tmartin07/Vehicle-wiring-diagrams/README.md

Vehicle-wiring-diagrams
=======================

OBSOLETE: USE FILES FROM BOX INSTEAD - Block diagrams and wiring diagrams between electrical modules on the vehicle.
