tmartin07/Vehicle-wiring-diagrams/M12 CAN.pdf

Pin | Name | Function | Wire color*
1 Brown | Shield | CAN Shield
2 White | +12V | +12V CAN Power
3 Blue | GND | CAN Ground
4 Black | CAN_H | CAN High
5 Green/Yellow | CAN_L | CAN Low

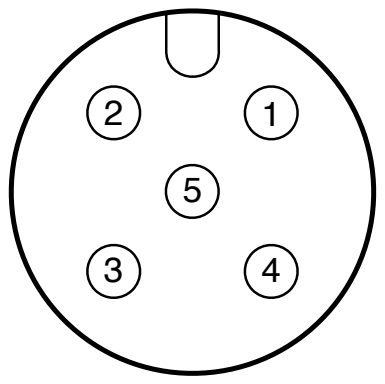
[picture p1: figure]

M12 5-position

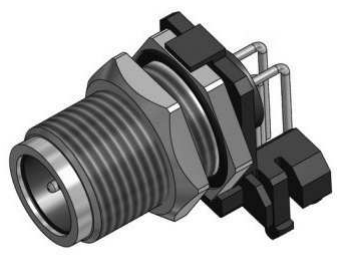
[picture p2: figure]

Connector name | M12 CAN
Drawing date | 05/19/15
Drawn by | Victor Brechbill

*Wire colors given are for Conec 43-1005x cable assemblies
