tmartin07/Vehicle-wiring-diagrams/MCN Breakout Pinouts.xls

Connector Number | Connector Type | Pin Number | Signal Type | MCN Signal | Associated Sensor
Front Magic CAN Node Breakout
X-401 | 8-pos M8 | 1 | 5V | +5V | Front WSS
 |  | 2 | 3V3 | +3V3 | Front Suspension
 |  | 3 | GPIO_5 | GP0 | Front WSS
 |  | 4 | Analog_3 | AIN-1 | Front Suspension
 |  | 5 | N/C
 |  | 6 | GND | GND | Front Suspension
 |  | 7 | GND | GND | Front WSS
 |  | 8 | N/C
X-402 | 8-pos M8 | 1 | 5V | +5V | Front Brake Pressure
 |  | 2 | 3V3 | +3V3 | Steering Angle
 |  | 3 | Analog_5 | AIN-2 | Front Brake Pressure
 |  | 4 | Analog_3 | AIN-3 | Steering Angle
 |  | 5 | Analog_3 | AIN-4 | Ambient Temperature
 |  | 6 | GND | GND | Ambient Temperature
 |  | 7 | GND | GND | Front Brake Pressure
 |  | 8 | GND | GND | Steering Angle
X-403 | 8-pos M8 | 1 | 5V | +5V | Radiator Air Pressure
 |  | 2 | N/C
 |  | 3 | Analog_5 | AIN-5 | Radiator Air Pressure 1
 |  | 4 | Analog_3 | AIN-6 | Radiator Coolant Temperature
 |  | 5 | N/C
 |  | 6 | Analog_5 | AIN-8 | Radiator Air Pressure 2
 |  | 7 | GND | GND | Radiator Coolant Temperature
 |  | 8 | GND | GND | Radiator Air Pressure
X-329 | 4-pos Micro-Fit | 1 | 5V | +5V | Ambient Pressure
 |  | 2 | Analog_5 | AIN-7 | Ambient Pressure
 |  | 3 | GND | GND | Ambient Pressure
 |  | 4 | N/C
Drive Control Magic CAN Node Breakout (attached to Front MCN Breakout board)
X-411 | 8-pos M8 | 1 | N/C
 |  | 2 | 3V3 | +3V3 | Power to Throttle
 |  | 3 | GPIO_12 | GP0 | Throttle Enable
 |  | 4 | Analog_3 | AIN-1 | Throttle
 |  | 5 | N/C
 |  | 6 | GND | GND | Ground to Throttle
 |  | 7 | N/C
 |  | 8 | N/C
Mid Magic CAN Node Breakout
X-404 | 8-pos M8 | 1 | 5V | +5V | Coolant Flow
 |  | 2 | GND | GND | Motor Coolant Temperature
 |  | 3 | GPIO_5 | GP0 | Coolant Flow
 |  | 4 | Analog_3 | AIN-11 | Motor Coolant Temperature
 |  | 5 | Analog_3 | AIN-12 | M/C Coolant Temperature
 |  | 6 | GND | GND | M/C Coolant Temperature
 |  | 7 | GND | GND | Coolant Flow
 |  | 8 | N/C
X-405 | 8-pos M8 | 1 | 5V | +5V | Motor Air Pressure
 |  | 2 | GND | GND | Motor Plate Temperature #1
 |  | 3 | Analog_5 | AIN-1 | Motor Air Pressure 1
 |  | 4 | Analog_3 | AIN-2 | Motor Plate Temperature #1
 |  | 5 | Analog_3 | AIN-3 | Motor Plate Temperature #2
 |  | 6 | Analog_5 | AIN-4 | Motor Air Pressure 2
 |  | 7 | GND | GND | Motor Air Pressure
 |  | 8 | GND | GND | Motor Plate Temperature #2
X-406 | 8-pos M8 | 1 | 5V | +5V | Strain Gauge
 |  | 2 | GND | GND | Strain Gauge
 |  | 3 | Analog_5 | AIN-5 | Strain Gauge
 |  | 4 | Analog_5 | AIN-6 | Strain Gauge
 |  | 5 | Analog_5 | AIN-7 | Strain Gauge
 |  | 6 | N/C
 |  | 7 | N/C
 |  | 8 | N/C
X-407 | 8-pos M8 | 1 | 5V | +5V | Strain Gauge
 |  | 2 | GND | GND | Strain Gauge
 |  | 3 | Analog_5 | AIN-8 | Strain Gauge
 |  | 4 | Analog_5 | AIN-9 | Strain Gauge
 |  | 5 | Analog_5 | AIN-10 | Strain Gauge
 |  | 6 | N/C
 |  | 7 | N/C
 |  | 8 | N/C
Rear Magic CAN Node Breakout
X-408 | 8-pos M8 | 1 | 3V3 | +3V3 | Rear Suspension
 |  | 2 | GND | GND | Rear Suspension
 |  | 3 | Analog_5 | AIN-1 | Rear Suspension
 |  | 4 | N/C
 |  | 5 | N/C
 |  | 6 | N/C
 |  | 7 | N/C
 |  | 8 | N/C
X-409 | 8-pos M8 | 1 | 5V | +5V | Rear WSS
 |  | 2 | GND | GND | Rear WSS
 |  | 3 | GPIO_5 | GP0 | Rear WSS
 |  | 4 | N/C
 |  | 5 | N/C
 |  | 6 | N/C
 |  | 7 | N/C
 |  | 8 | N/C
X-410 | 8-pos M8 | 1 | 5V | +5V | Rear Brake Pressure
 |  | 2 | GND | GND | Rear Brake Pressure
 |  | 3 | Analog_5 | AIN-2 | Rear Brake Pressure
 |  | 4 | N/C
 |  | 5 | N/C
 |  | 6 | N/C
 |  | 7 | N/C
 |  | 8 | N/C
X-336 | 4-pos Micro-Fit | 1 | 12V | +12V | Frame Fault
 |  | 2 | GND | GND | Frame Fault
 |  | 3 | Analog_12 | AIN-10 | 12V Standby
 |  | 4 | GPIO_12 | GP1 | Frame Fault
X-337 | 4-pos Micro-Fit | 1 | Analog_3 | AIN-3 | 12V Shunt
 |  | 2 | 3V3 | +3V3 | Power to 12V Shunt
 |  | 3 | Analog_3 | AIN-5 | DC-DC Temperature
 |  | 4 | GND | GND | DC-DC Temperature
X-413 | 8-pos M8 | 1 | 5V | +5V | Spare
 |  | 2 | 3V3 | +3V3
 |  | 3 | Analog_5 | AIN-6
 |  | 4 | Analog_3 | AIN-7
 |  | 5 | Analog_3 | AIN-8
 |  | 6 | GND | GND
 |  | 7 | GND | GND
 |  | 8 | GND | GND
Dyno MCN Breakout
X-5002 | 10-pos MicroClasp | 1 | 5V | +5V | Coolant Flow
 |  | 2 | GND | GND | Motor Coolant Temperature
 |  | 3 | GPIO_5 | GP0 | Coolant Flow
 |  | 4 | Analog_3 | AIN-11 | Motor Coolant Temperature
 |  | 5 | Analog_3 | AIN-12 | M/C Coolant Temperature
 |  | 6 | GND | GND | M/C Coolant Temperature
 |  | 7 | Analog_3 | AIN-10 | Radiator Coolant Temperature
 |  | 8 | GND | GND | Radiator Coolant Temperature
 |  | 9 | GND | GND | Coolant Flow
 |  | 10 | N/C
X-5003 | 10-pos MicroClasp | 1 | 5V | +5V | Coolant Pressure Sensor #1
 |  | 2 | Analog_5 | AIN-1 | Coolant Pressure Sensor #1
 |  | 3 | GND | GND | Coolant Pressure Sensor #1
 |  | 4 | 5V | +5V | Coolant Pressure Sensor #2
 |  | 5 | Analog_5 | AIN-2 | Coolant Pressure Sensor #2
 |  | 6 | N/C
 |  | 7 | N/C
 |  | 8 | N/C
 |  | 9 | N/C
 |  | 10 | GND | GND | Coolant Pressure Sensor #2
Rear CAN Backplane
X-340 | 2-pos Micro-Fit | 1 | 12V |  | CAN Power
 |  | 2 | GND
X-206 | 5-pos M12 | 1 | Shield |  | Tank Enclosure (CAN 2)
 |  | 2 | 12V
 |  | 3 | GND
 |  | 4 | CAN-H
 |  | 5 | CAN-L
X-207 | 5-pos M12 | 1 | Shield |  | Rear Tire Temperature
 |  | 2 | 12V
 |  | 3 | GND
 |  | 4 | CAN-H
 |  | 5 | CAN-L
X-339 | 6-pos Micro-Fit | 1 | 12V |  | Rear MCN
 |  | 2 | GND
 |  | 3 | Shield
 |  | 4 | CAN-H
 |  | 5 | CAN-L
 |  | 6 | Shield GND
Tank CAN Backplane
X-203 | 5-pos M12 | 1 | Shield |  | Motor Controller (CAN A)
 |  | 2 | 12V
 |  | 3 | GND
 |  | 4 | CAN-H
 |  | 5 | CAN-L
X-205 | 5-pos M12 | 1 | Shield |  | Front Tire Temperature (CAN 2)
 |  | 2 | 12V
 |  | 3 | GND
 |  | 4 | CAN-H
 |  | 5 | CAN-L
X-202 | 5-pos M12 | 1 | Shield |  | Rear Enclosure (CAN 2)
 |  | 2 | 12V
 |  | 3 | GND
 |  | 4 | CAN-H
 |  | 5 | CAN-L
X-201 | 5-pos M12 | 1 | Shield |  | Front Enclosure (CAN 2)
 |  | 2 | 12V
 |  | 3 | GND
 |  | 4 | CAN-H
 |  | 5 | CAN-L
X-204 | 5-pos M12 | 1 | Shield |  | BMS (CAN 2)
 |  | 2 | 12V
 |  | 3 | GND
 |  | 4 | CAN-H
 |  | 5 | CAN-L
X-321 | 6-pos Micro-Fit | 1 | 12V |  | Interface Panel (CAN A)
 |  | 2 | GND
 |  | 3 | Shield
 |  | 4 | CAN-H
 |  | 5 | CAN-L
 |  | 6 | Shield GND
X-322 | 6-pos Micro-Fit | 1 | 12V |  | Drive Control MCN (CAN A)
 |  | 2 | GND
 |  | 3 | Shield
 |  | 4 | CAN-H
 |  | 5 | CAN-L
 |  | 6 | Shield GND
X-320 | 6-pos Micro-Fit | 1 | 12V |  | CAN Mirror (CAN A)
 |  | 2 | GND
 |  | 3 | Shield
 |  | 4 | CAN-H
 |  | 5 | CAN-L
 |  | 6 | Shield GND
X-319 | 6-pos Micro-Fit | 1 | 12V |  | CAN Mirror (CAN 2)
 |  | 2 | GND
 |  | 3 | Shield
 |  | 4 | CAN-H
 |  | 5 | CAN-L
 |  | 6 | Shield GND
X-318 | 6-pos Micro-Fit | 1 | 12V |  | Front MCN (CAN 2)
 |  | 2 | GND
 |  | 3 | Shield
 |  | 4 | CAN-H
 |  | 5 | CAN-L
 |  | 6 | Shield GND
X-317 | 6-pos Micro-Fit | 1 | 12V |  | IMU MCN (CAN 2)
 |  | 2 | GND
 |  | 3 | Shield
 |  | 4 | CAN-H
 |  | 5 | CAN-L
 |  | 6 | Shield GND
X-316 | 6-pos Micro-Fit | 1 | 12V |  | Mid MCN (CAN 2)
 |  | 2 | GND
 |  | 3 | Shield
 |  | 4 | CAN-H
 |  | 5 | CAN-L
 |  | 6 | Shield GND
X-314 | 6-pos Micro-Fit | 1 | 12V |  | Kvaser (CAN 2)
 |  | 2 | GND
 |  | 3 | Shield
 |  | 4 | CAN-H
 |  | 5 | CAN-L
 |  | 6 | Shield GND
X-315 | 6-pos Micro-Fit | 1 | 12V |  | Interface Panel (CAN 2)
 |  | 2 | GND
 |  | 3 | Shield
 |  | 4 | CAN-H
 |  | 5 | CAN-L
 |  | 6 | Shield GND
X-313 | 2-pos Micro-Fit | 1 | 12V |  | Starlane
 |  | 2 | GND
