tmartin07/Vehicle-wiring-diagrams/PL-8 Balance Harness.pdf

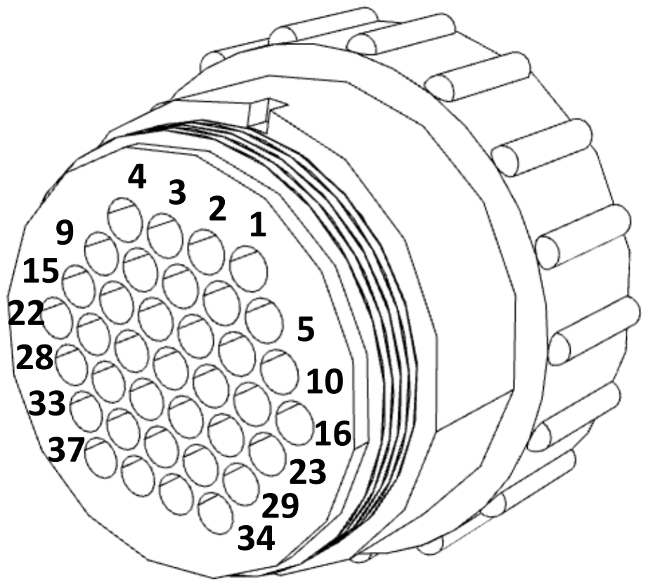
[picture p3: figure]

PL-8 Balance Harness
Victor Brechbill

05/19/15
Last modified: 2015-05-20

Page 1/1

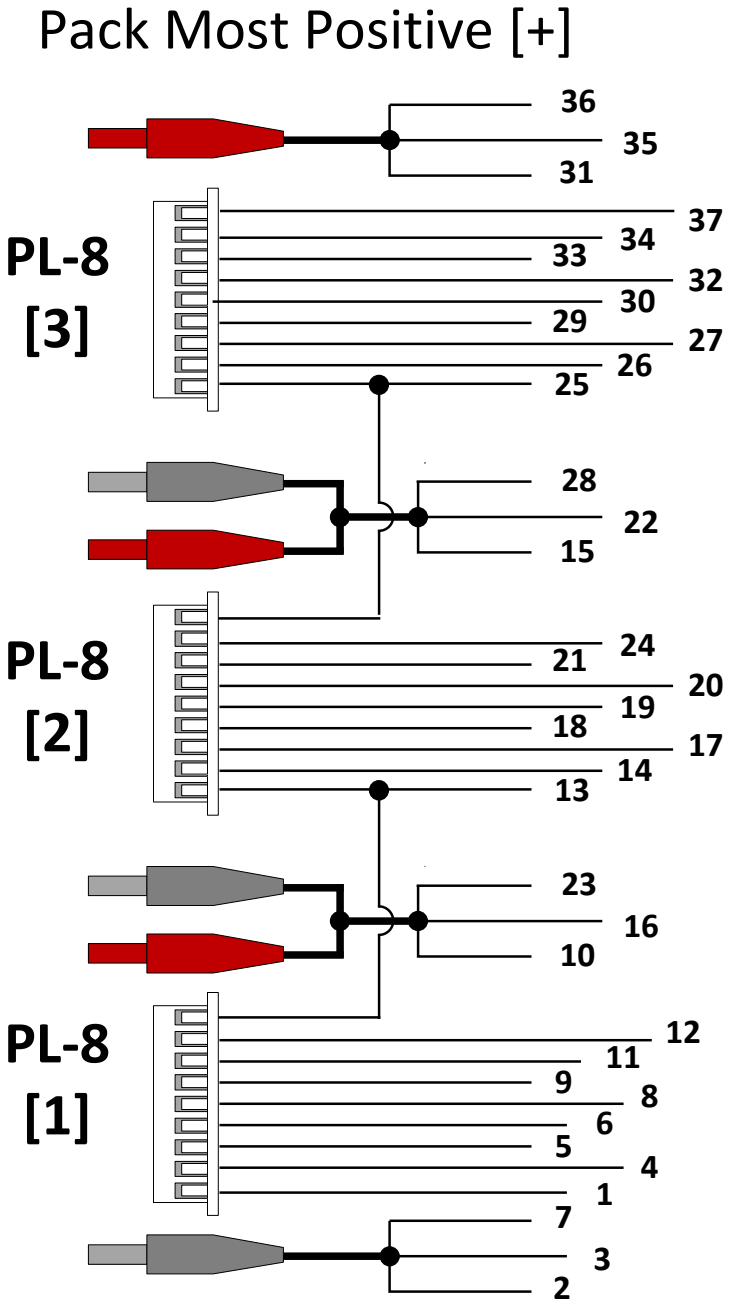
[picture p4: figure]
Pack Most Positive [+]

Pack Most Negative [-]

Back Side of Male Plug
(PN: 206305-1)
