tmartin07/Vehicle-wiring-diagrams/Complete System/System Block Diagram.pdf

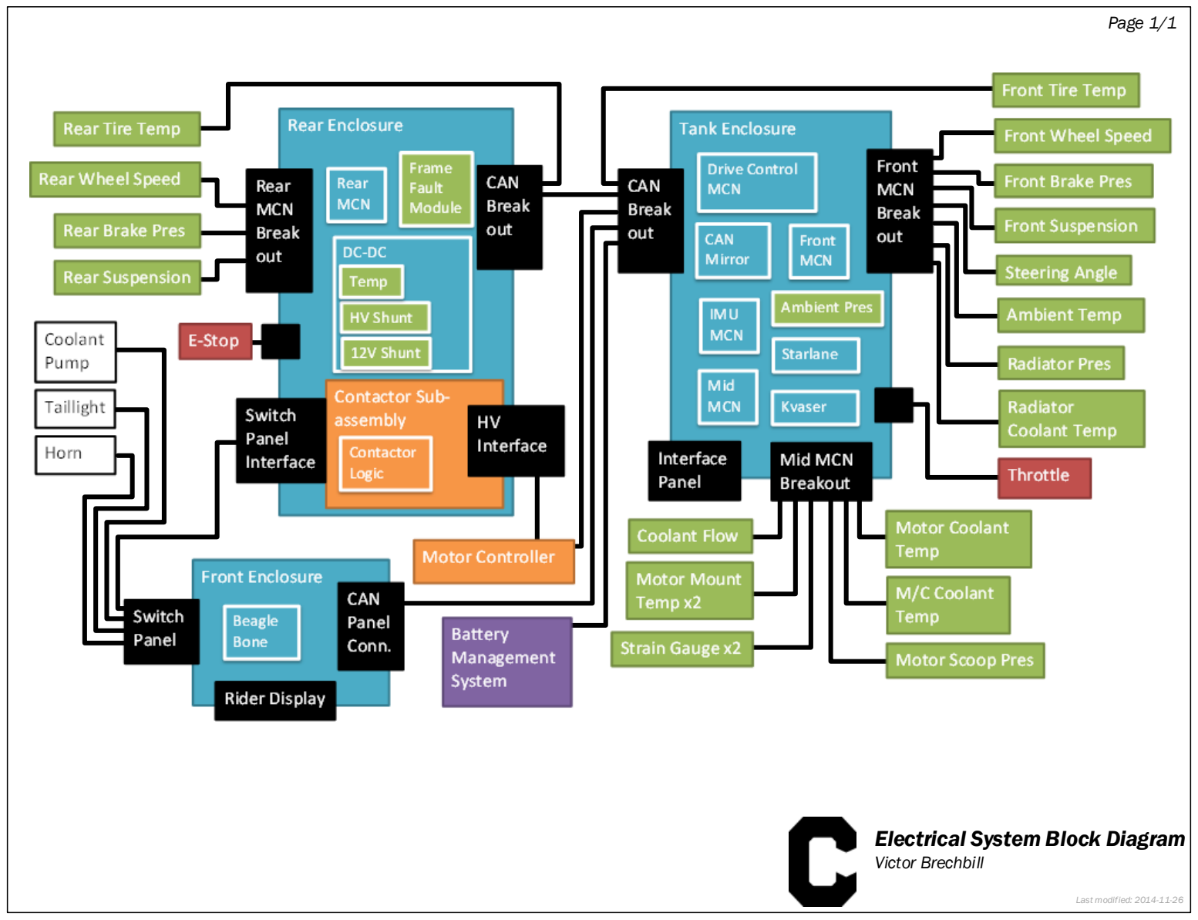
[picture p5: page 1]

Electrical System Block Diagram
Victor Brechbill

Last modified: 2014-11-26
