tmartin07/Vehicle-wiring-diagrams/Motor interface/RW-3 motor interface.pdf

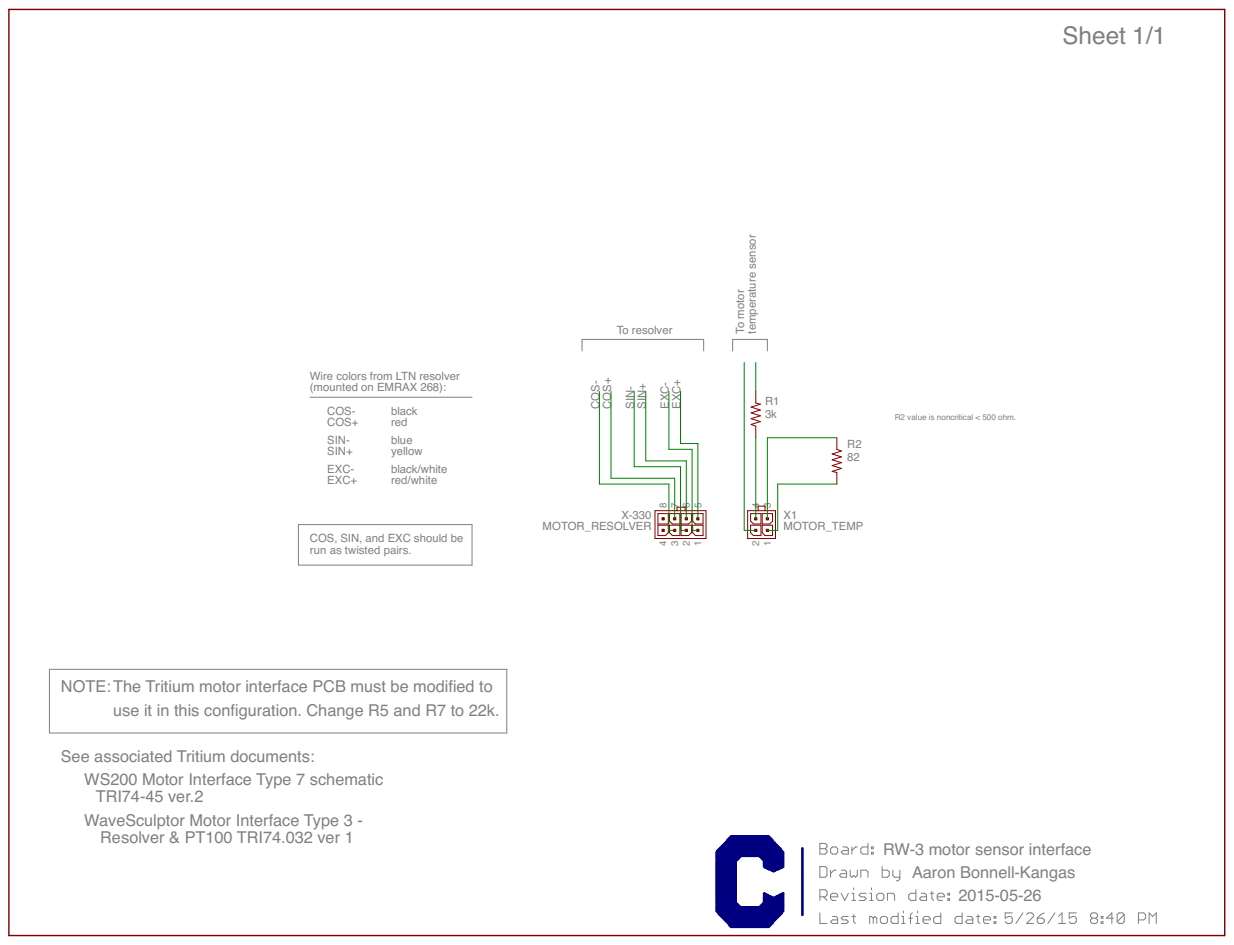
[picture p6: page 1]

Wire colors from LTN resolver COS- COS+ SIN- SIN+ EXC- EXC+
(mounted on EMRAX 268):

black/white blue black
red

R2 value is noncritical < 500 ohm.

COS, SIN, and EXC should be
run as twisted pairs.

use it in this configuration. Change R5 and R7 to 22k. The Tritium motor interface PCB must be modified to

See associated Tritium documents:
WS200 Motor Interface Type 7 schematic
TRI74-45 ver.2
WaveSculptor Motor Interface Type 3 - Resolver & PT100 TRI74.032 ver 1

RW-3 motor sensor interface
Aaron Bonnell-Kangas
