tmartin07/Vehicle-wiring-diagrams/Complete System/RW-3 Electrical System Diagram.pdf

## Front Enclosure

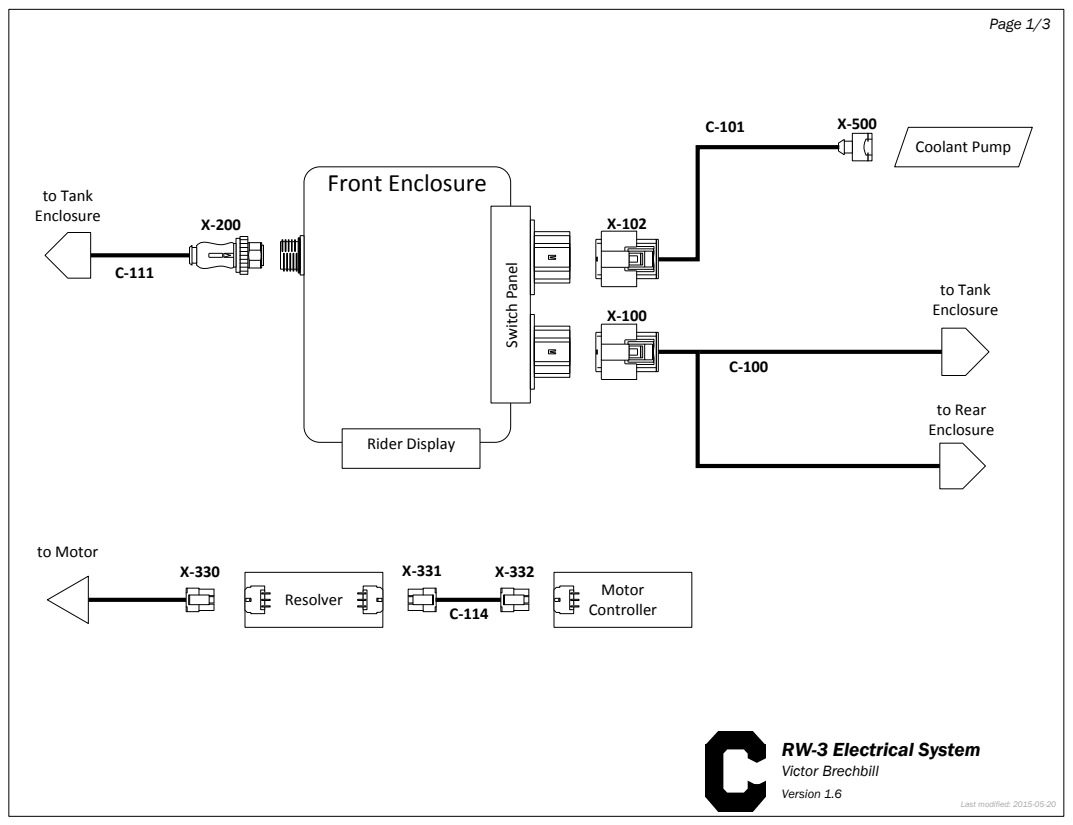
[picture p7: page 1]
Version 1.6; Last modified: 2015-05-20; Page 1/3; Switch Panel; Rider Display; Coolant Pump; to Rear Enclosure; to Tank Enclosure; Resolver; to Motor; Motor Controller

RW-3 Electrical System
Victor Brechbill

## Tank Enclosure

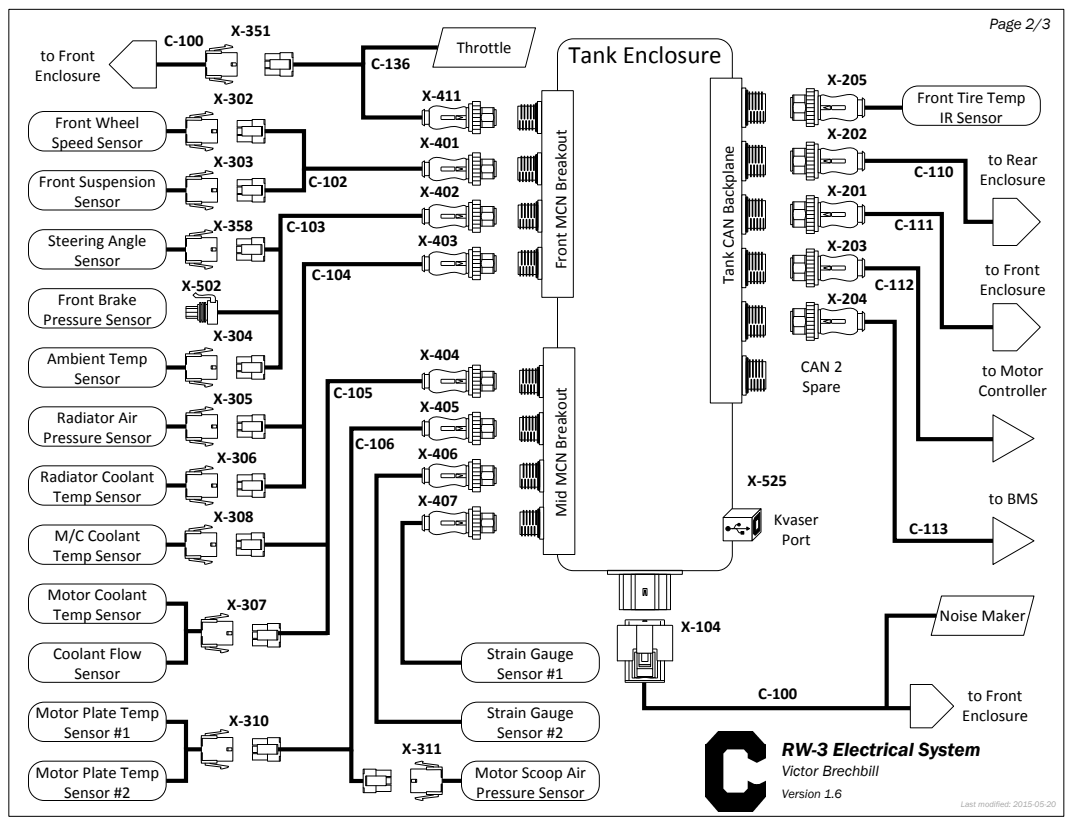
[picture p8: page 2]
Page 2/3; Front Wheel Speed Sensor; Front Suspension Sensor; Steering Angle Sensor; Front Brake Pressure Sensor; Ambient Temp Sensor; Radiator Air Pressure Sensor; Radiator Coolant Temp Sensor; M/C Coolant Temp Sensor; Motor Coolant Temp Sensor; Coolant Flow Sensor; Strain Gauge Sensor #1; Strain Gauge Sensor #2; to Motor Controller; to BMS; Throttle; Noise Maker; to Front Enclosure; Kvaser Port; CAN 2 Spare

Front Tire Temp
IR Sensor

Mid MCN Breakout Front MCN Breakout

Tank CAN Backplane to Front Enclosure to Rear Enclosure

Motor Plate Temp
Sensor #1

RW-3 Electrical System

Sensor #2

Motor Scoop Air
Pressure Sensor

## Rear Enclosure

E

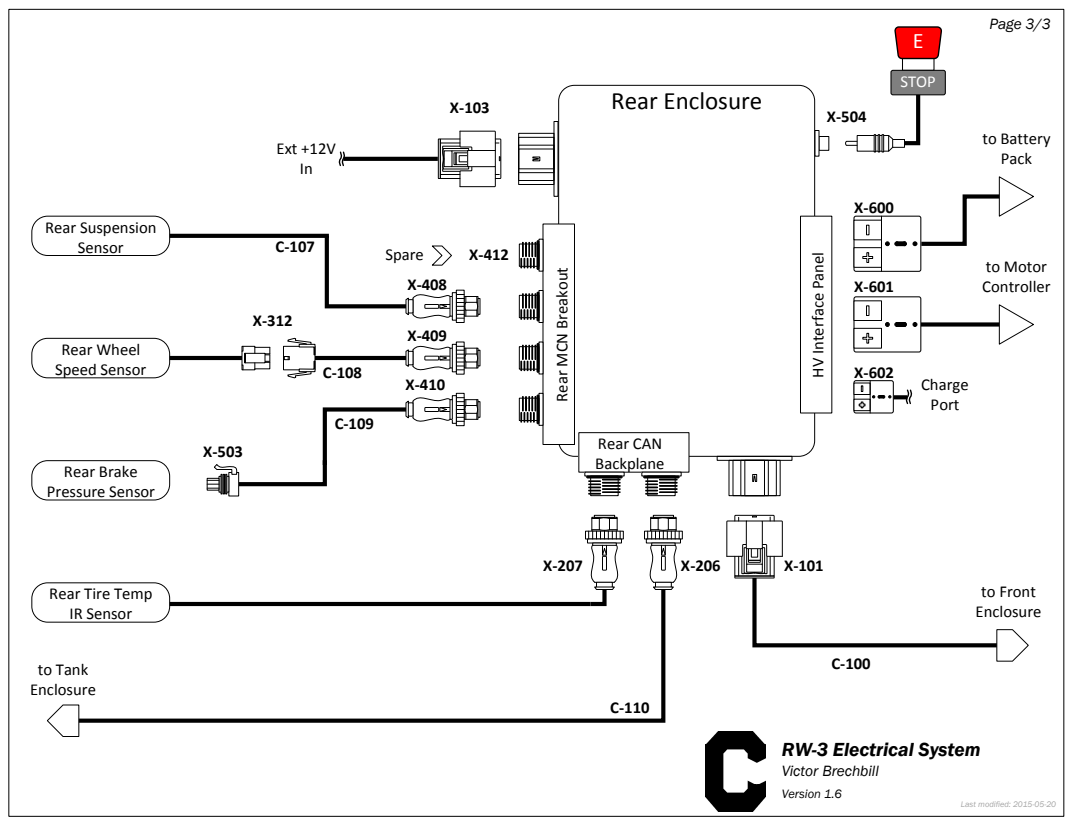
[picture p9: page 3]
Page 3/3; STOP; Rear Suspension Sensor; Rear Wheel Speed Sensor; Rear Brake Pressure Sensor; Spare; Rear CAN Backplane; Charge Port; to Front Enclosure; to Tank Enclosure; to Battery Pack; to Motor Controller; Ext +12V In

HV Interface Panel

Rear MCN Breakout

Rear Tire Temp
IR Sensor

RW-3 Electrical System
