tmartin07/Vehicle-wiring-diagrams/Complete System/X-310.pdf

## Micro-Fit - 4-circuit

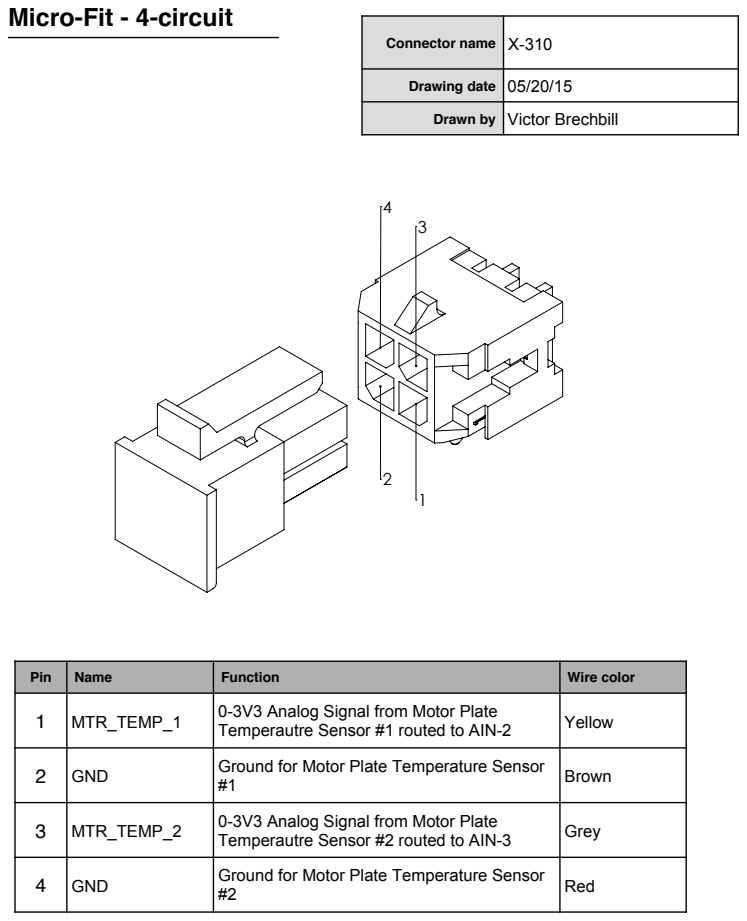
[picture p10: page 1]

Connector name | X-310

Drawing date | 05/20/15

Drawn by | Victor Brechbill

Pin | Name | Function | Wire color

1 | MTR_TEMP_1 | 0-3V3 Analog Signal from Motor Plate Temperautre Sensor #1 routed to AIN-2 | Yellow

2 | GND | Ground for Motor Plate Temperature Sensor #1 | Brown

3 | MTR_TEMP_2 | 0-3V3 Analog Signal from Motor Plate Temperautre Sensor #2 routed to AIN-3 | Grey

4 | GND | Ground for Motor Plate Temperature Sensor #2 | Red
