tmartin07/Vehicle-wiring-diagrams/Complete System/X-311.pdf

## Micro-Fit - 4-circuit

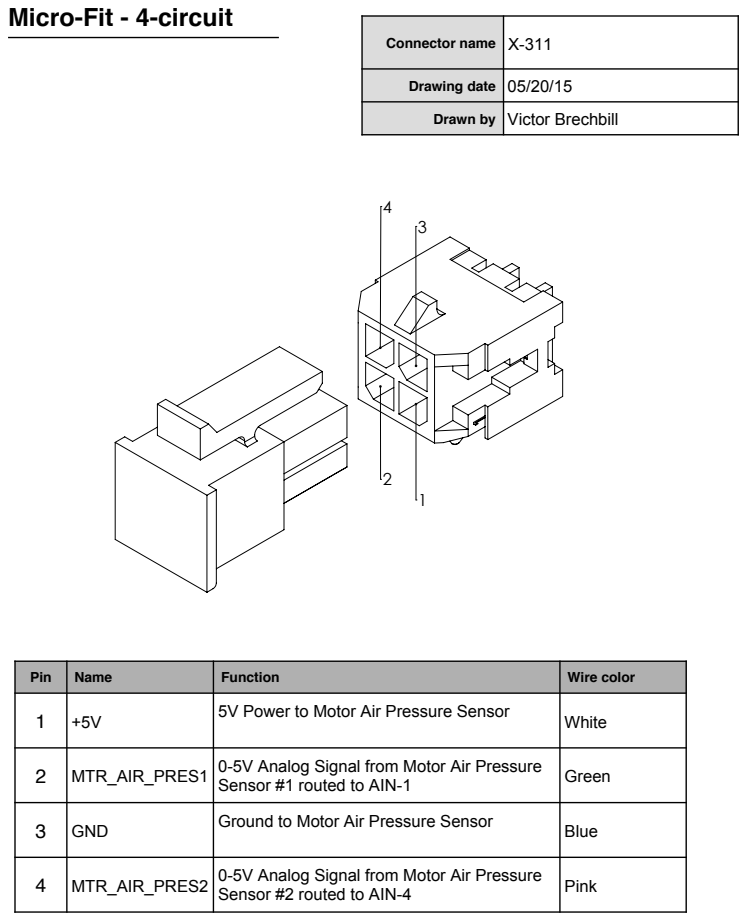
[picture p11: page 1]

Connector name | X-311

Drawing date | 05/20/15

Drawn by | Victor Brechbill

Pin | Name | Function | Wire color

1 | +5V | 5V Power to Motor Air Pressure Sensor | White

2 | MTR_AIR_PRES1 | 0-5V Analog Signal from Motor Air Pressure Sensor #1 routed to AIN-1 | Green

3 | GND | Ground to Motor Air Pressure Sensor | Blue

4 | MTR_AIR_PRES2 | 0-5V Analog Signal from Motor Air Pressure Sensor #2 routed to AIN-4 | Pink
