tmartin07/Vehicle-wiring-diagrams/Complete System/X-358.pdf

## Micro-Fit - 4-circuit

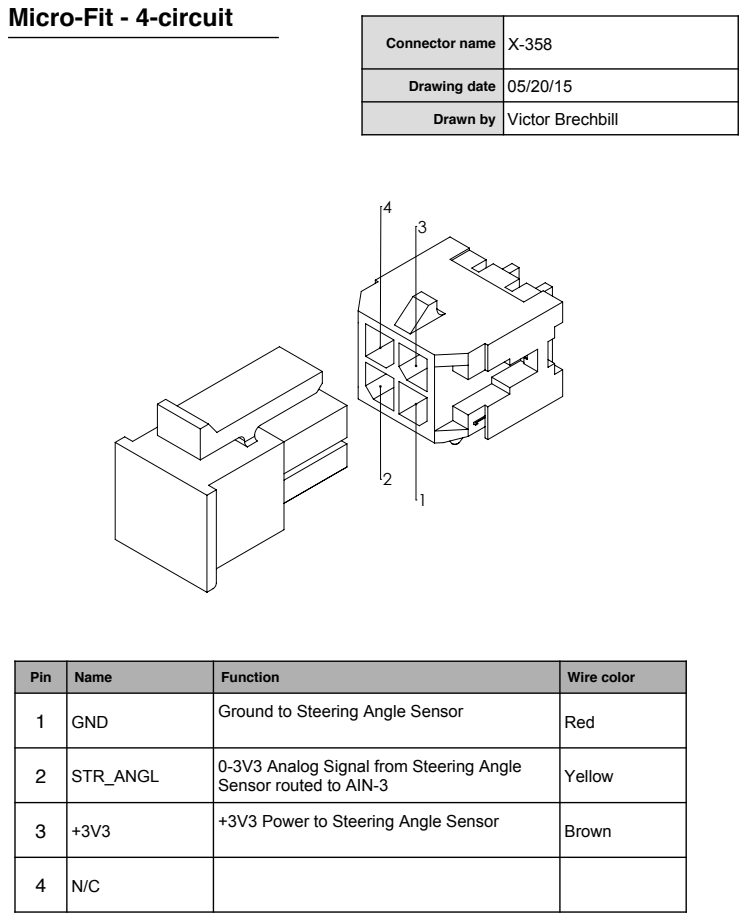
[picture p12: page 1]

Connector name | X-358

Drawing date | 05/20/15

Drawn by | Victor Brechbill

Pin | Name | Function | Wire color

1 | GND | Ground to Steering Angle Sensor | Red

2 | STR_ANGL | 0-3V3 Analog Signal from Steering Angle Sensor routed to AIN-3 | Yellow

3 | +3V3 | +3V3 Power to Steering Angle Sensor | Brown
