tmartin07/Vehicle-wiring-diagrams/Rear Enclosure/X-336.pdf

## Micro-Fit - 4-circuit

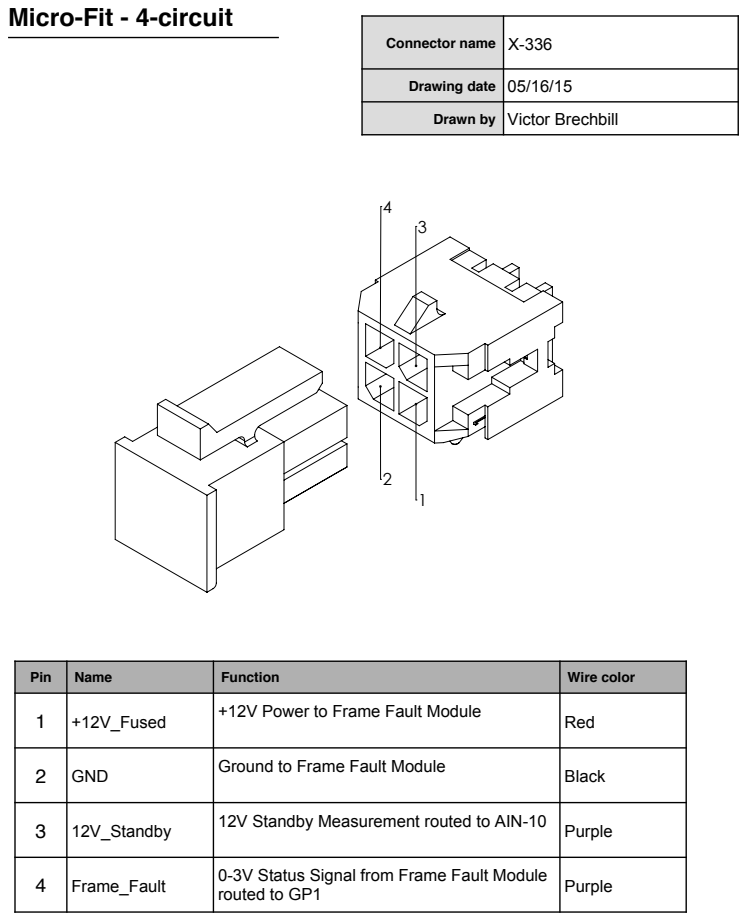
[picture p13: page 1]

Connector name | X-336

Drawing date | 05/16/15

Drawn by | Victor Brechbill

Pin | Name | Function | Wire color

1 | +12V_Fused | +12V Power to Frame Fault Module | Red

2 | GND | Ground to Frame Fault Module | Black

3 | 12V_Standby | 12V Standby Measurement routed to AIN-10 | Purple

4 | Frame_Fault | 0-3V Status Signal from Frame Fault Module routed to GP1 | Purple
