tmartin07/Vehicle-wiring-diagrams/Rear Enclosure/X-337.pdf

## Micro-Fit - 4-circuit

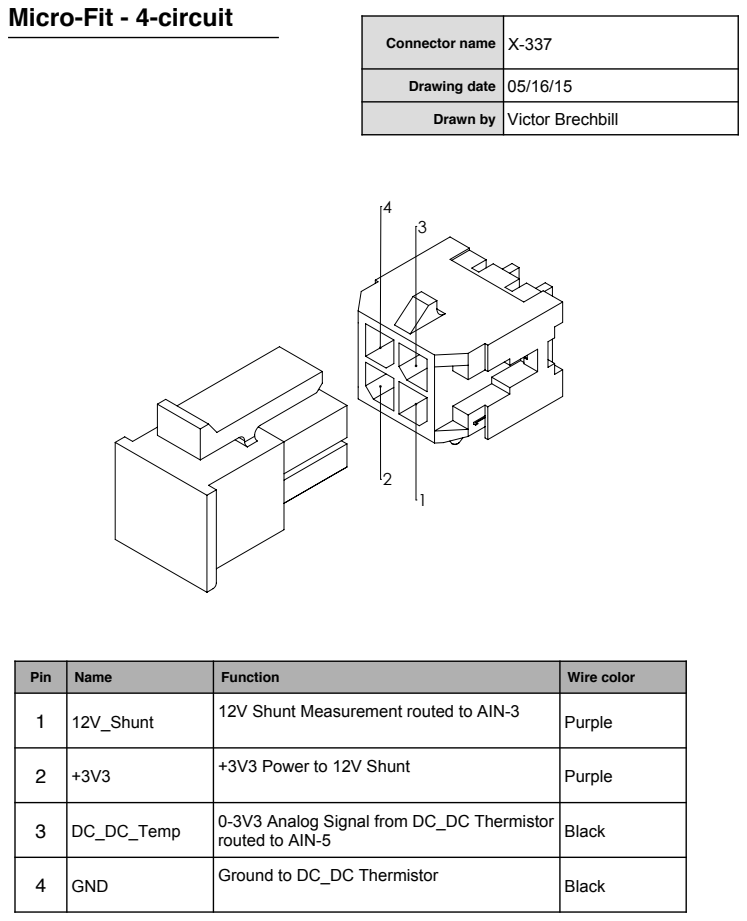
[picture p14: page 1]

Connector name | X-337

Drawing date | 05/16/15

Drawn by | Victor Brechbill

Pin | Name | Function | Wire color

1 | 12V_Shunt | 12V Shunt Measurement routed to AIN-3 | Purple

2 | +3V3 | +3V3 Power to 12V Shunt | Purple

3 | DC_DC_Temp | 0-3V3 Analog Signal from DC_DC Thermistor routed to AIN-5 | Black

4 | GND | Ground to DC_DC Thermistor | Black
