tmartin07/Vehicle-wiring-diagrams/Rear Enclosure/X-408.pdf

## M8 8-position

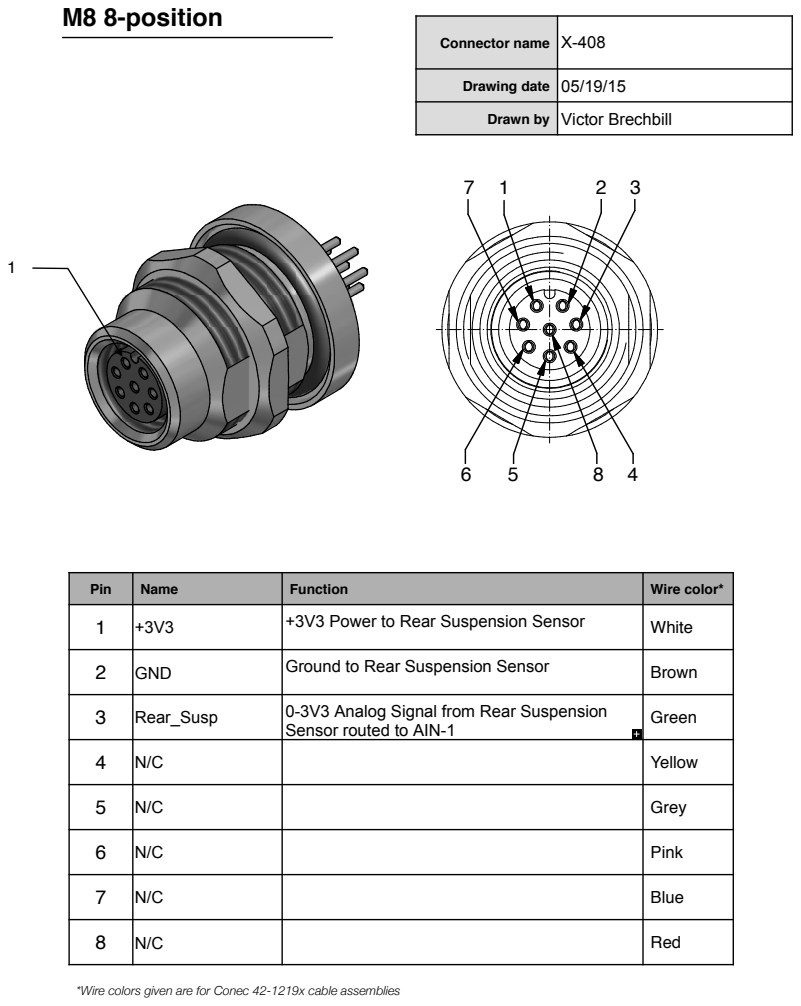
[picture p15: page 1]

Connector name | X-408

Drawing date | 05/19/15

Drawn by | Victor Brechbill

Pin | Name | Function | Wire color*

1 White | +3V3 | +3V3 Power to Rear Suspension Sensor

2 Brown | GND | Ground to Rear Suspension Sensor

3 Green | Rear_Susp | 0-3V3 Analog Signal from Rear Suspension

Sensor routed to AIN-1

4 Yellow | N/C

5 Grey | N/C

6 Pink | N/C

7 Blue | N/C

8 Red | N/C

*Wire colors given are for Conec 42-1219x cable assemblies
