tmartin07/Vehicle-wiring-diagrams/Rear Enclosure/X-409.pdf

## M8 8-position

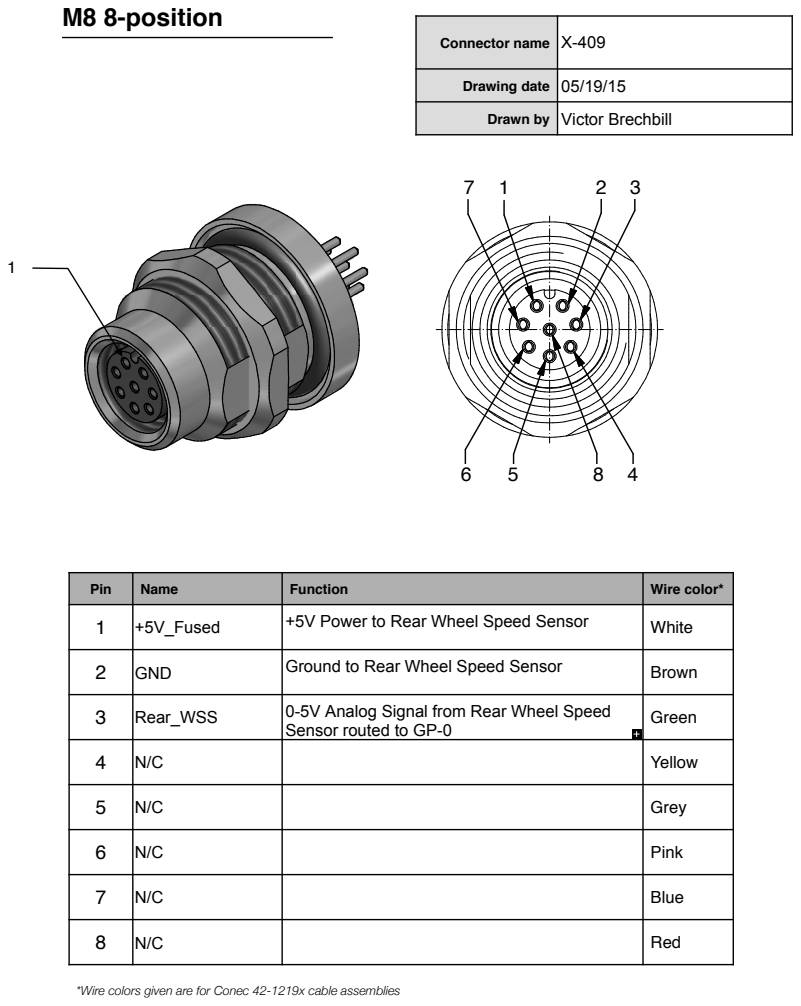
[picture p16: page 1]

Connector name | X-409

Drawing date | 05/19/15

Drawn by | Victor Brechbill

Pin | Name | Function | Wire color*

1 White | +5V_Fused | +5V Power to Rear Wheel Speed Sensor

2 Brown | GND | Ground to Rear Wheel Speed Sensor

3 Green | Rear_WSS | 0-5V Analog Signal from Rear Wheel Speed

Sensor routed to GP-0

4 Yellow | N/C

5 Grey | N/C

6 Pink | N/C

7 Blue | N/C

8 Red | N/C

*Wire colors given are for Conec 42-1219x cable assemblies
