tmartin07/Vehicle-wiring-diagrams/Rear Enclosure/X-410.pdf

## M8 8-position

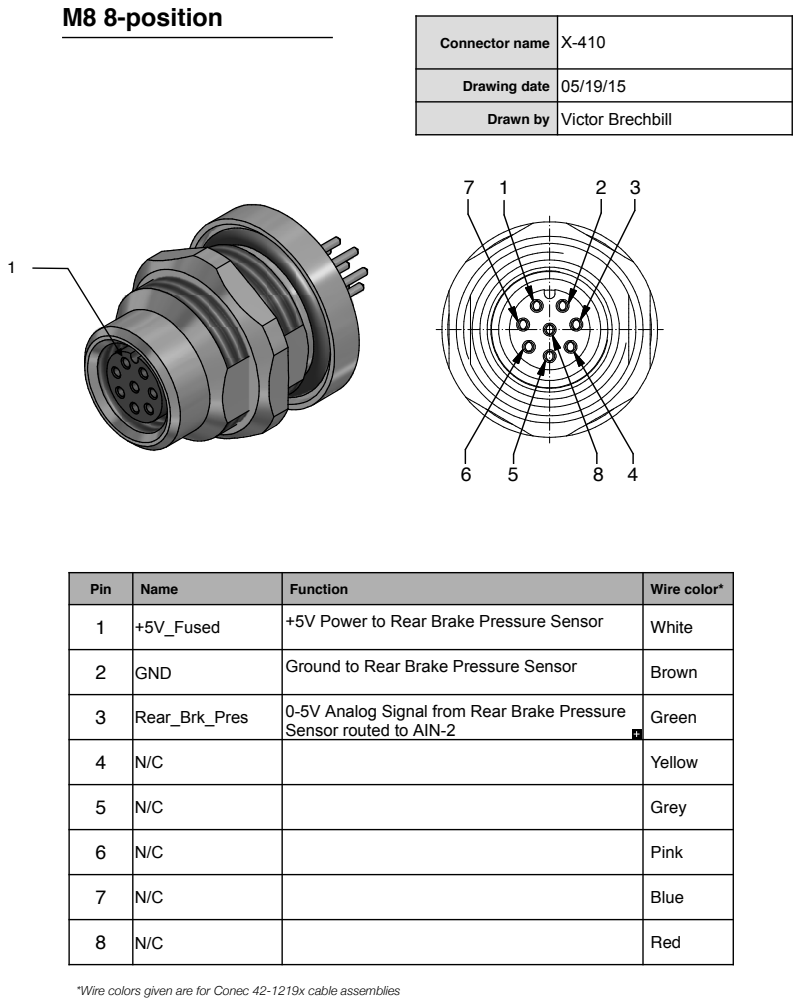
[picture p17: page 1]

Connector name | X-410

Drawing date | 05/19/15

Drawn by | Victor Brechbill

Pin | Name | Function | Wire color*

1 White | +5V_Fused | +5V Power to Rear Brake Pressure Sensor

2 Brown | GND | Ground to Rear Brake Pressure Sensor

3 Green | Rear_Brk_Pres | 0-5V Analog Signal from Rear Brake Pressure

Sensor routed to AIN-2

4 Yellow | N/C

5 Grey | N/C

6 Pink | N/C

7 Blue | N/C

8 Red | N/C

*Wire colors given are for Conec 42-1219x cable assemblies
