tmartin07/Vehicle-wiring-diagrams/Rear Enclosure/X-413.pdf

## M8 8-position

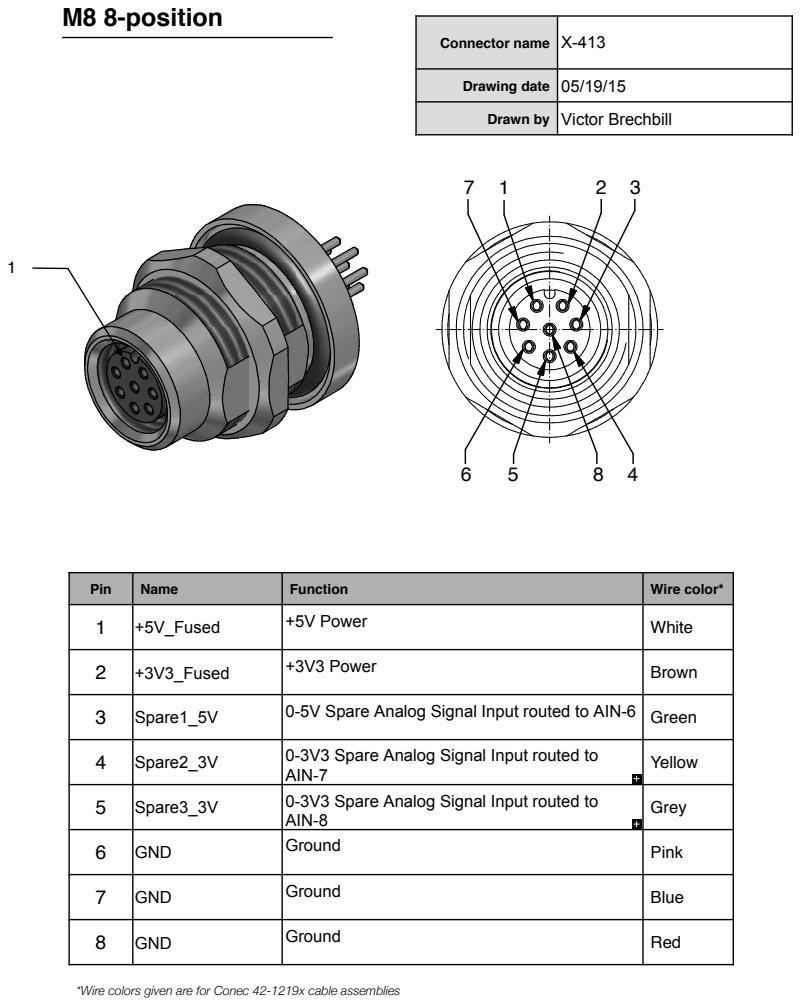
[picture p18: page 1]
AIN-7; AIN-8

Connector name | X-413

Drawing date | 05/19/15

Drawn by | Victor Brechbill

Pin | Name | Function | Wire color*

1 White | +5V_Fused | +5V Power

2 Brown | +3V3_Fused | +3V3 Power

3 Green | Spare1_5V | 0-5V Spare Analog Signal Input routed to AIN-6

4 Yellow | Spare2_3V | 0-3V3 Spare Analog Signal Input routed to

5 Grey | Spare3_3V | 0-3V3 Spare Analog Signal Input routed to

6 Pink | GND | Ground

7 Blue | GND | Ground

8 Red | GND | Ground

*Wire colors given are for Conec 42-1219x cable assemblies
