tmartin07/Vehicle-wiring-diagrams/Complete System/X-105.pdf

## MX-150L - 4-circuit

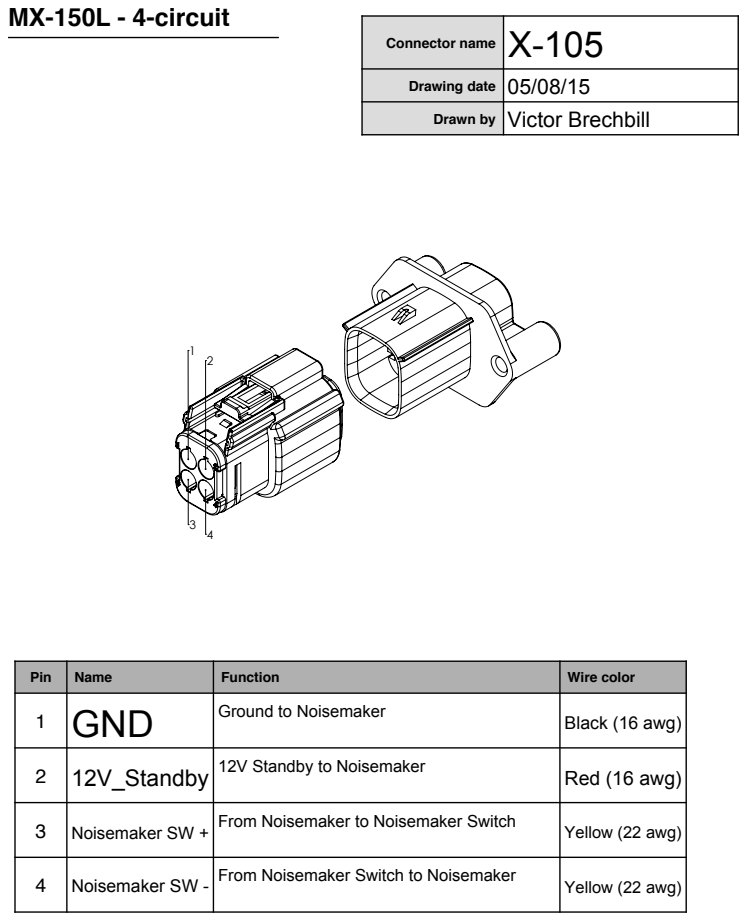
[picture p19: page 1]
0DWHGDVVHPEO\0;/SRV

Connector name | X-105

Drawing date | 05/08/15

Drawn by | Victor Brechbill

7KH2KLR6WDWH8QLYHUVLW\
'HSWRI0HFKDQLFDO $HURVSDFH(QJ

Pin | Name | Function | Wire color

1 | GND | Ground to Noisemaker | Black (16 awg)

2 | 12V_Standby | 12V Standby to Noisemaker | Red (16 awg)

3 | Noisemaker SW + | From Noisemaker to Noisemaker Switch | Yellow (22 awg)

4 | Noisemaker SW - | From Noisemaker Switch to Noisemaker | Yellow (22 awg)
