tmartin07/Vehicle-wiring-diagrams/Complete System/X-302.pdf

## Micro-Fit - 4-circuit

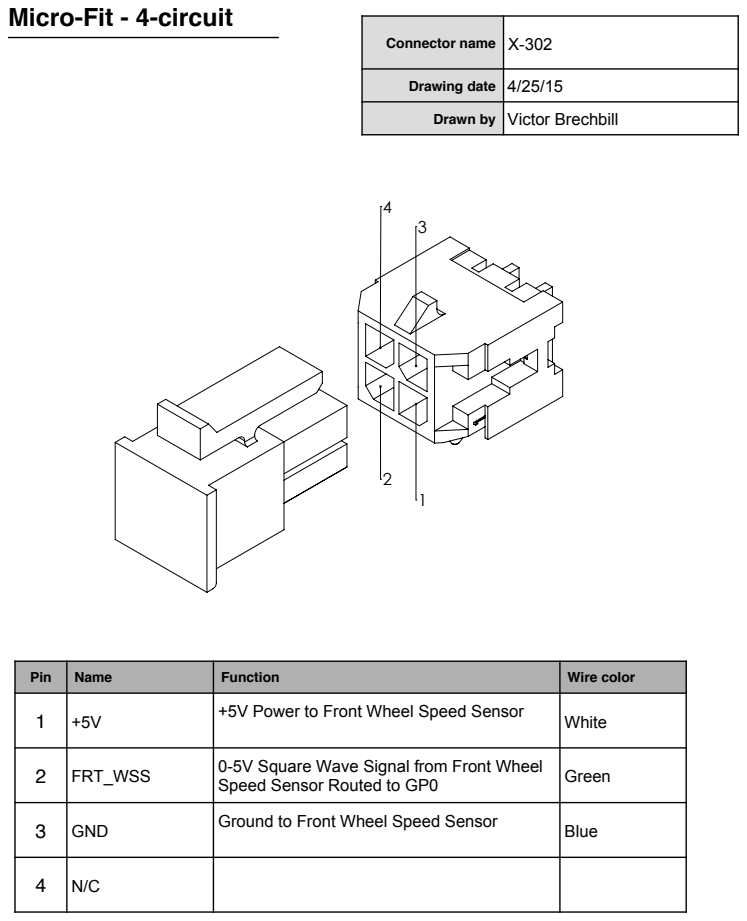
[picture p20: page 1]

Connector name | X-302

Drawing date | 4/25/15

Drawn by | Victor Brechbill

Pin | Name | Function | Wire color

1 | +5V | +5V Power to Front Wheel Speed Sensor | White

2 | FRT_WSS | 0-5V Square Wave Signal from Front Wheel Speed Sensor Routed to GP0 | Green

3 | GND | Ground to Front Wheel Speed Sensor | Blue
