tmartin07/Vehicle-wiring-diagrams/Complete System/X-303.pdf

## Micro-Fit - 4-circuit

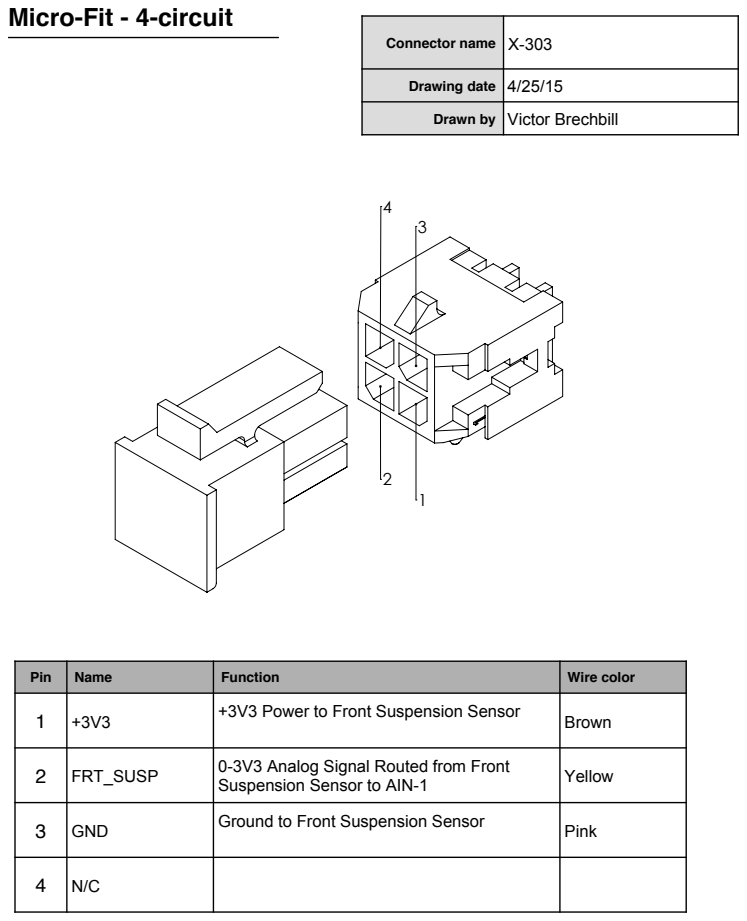
[picture p21: page 1]

Connector name | X-303

Drawing date | 4/25/15

Drawn by | Victor Brechbill

Pin | Name | Function | Wire color

1 | +3V3 | +3V3 Power to Front Suspension Sensor | Brown

2 | FRT_SUSP | 0-3V3 Analog Signal Routed from Front Suspension Sensor to AIN-1 | Yellow

3 | GND | Ground to Front Suspension Sensor | Pink
