tmartin07/Vehicle-wiring-diagrams/Complete System/X-305.pdf

## Micro-Fit - 4-circuit

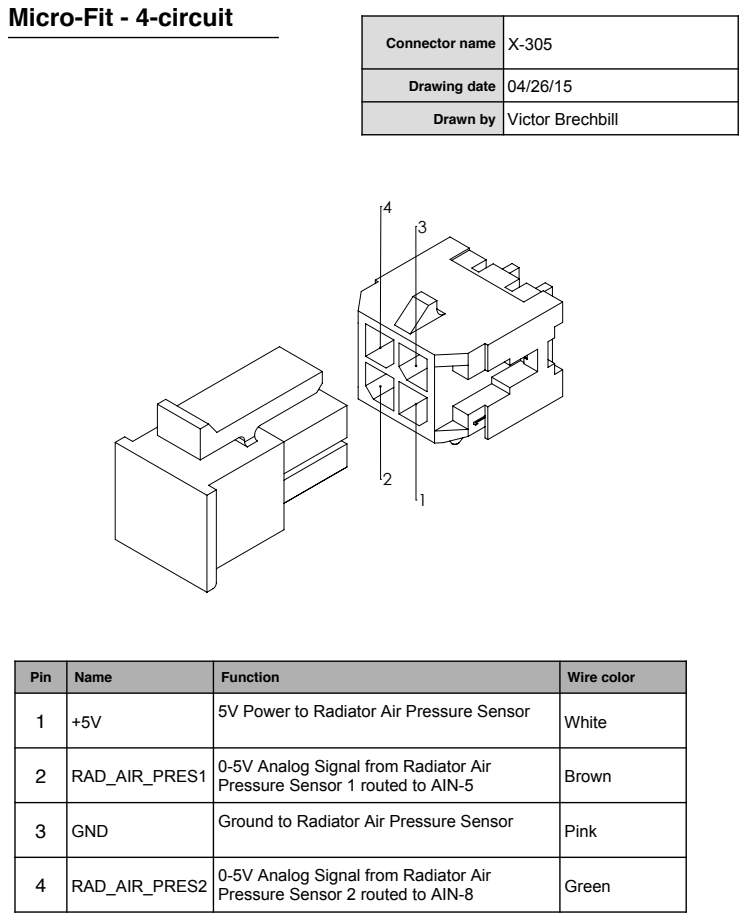
[picture p22: page 1]

Connector name | X-305

Drawing date | 04/26/15

Drawn by | Victor Brechbill

Pin | Name | Function | Wire color

1 | +5V | 5V Power to Radiator Air Pressure Sensor | White

2 | RAD_AIR_PRES1 | 0-5V Analog Signal from Radiator Air Pressure Sensor 1 routed to AIN-5 | Brown

3 | GND | Ground to Radiator Air Pressure Sensor | Pink

4 | RAD_AIR_PRES2 | 0-5V Analog Signal from Radiator Air Pressure Sensor 2 routed to AIN-8 | Green
