tmartin07/Vehicle-wiring-diagrams/Complete System/X-357.pdf

## Micro-Fit - 4-circuit

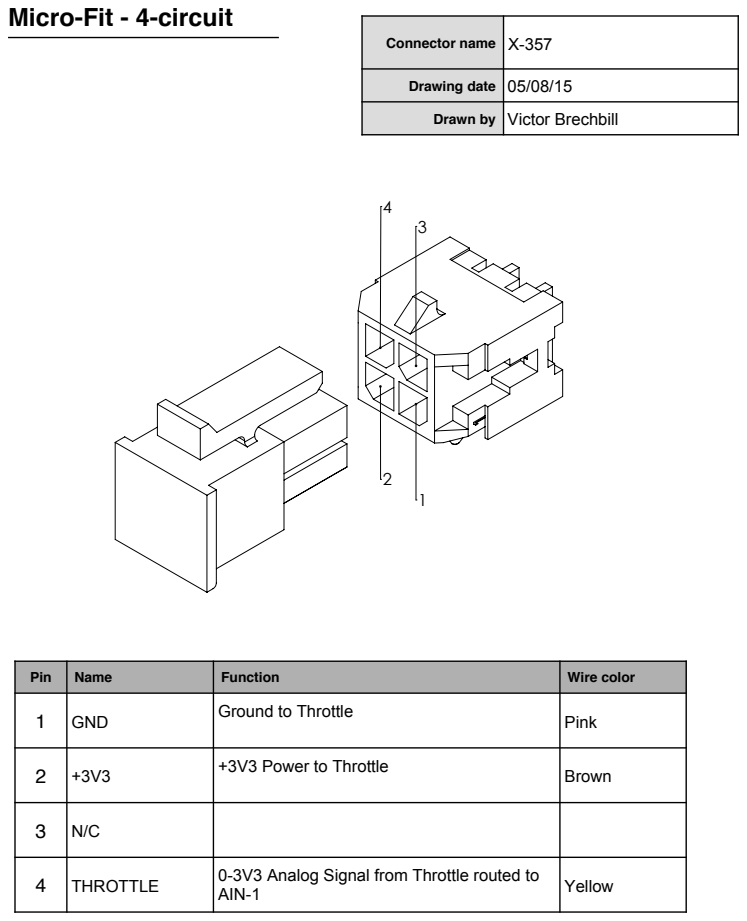
[picture p23: page 1]

Connector name | X-357

Drawing date | 05/08/15

Drawn by | Victor Brechbill

Pin | Name | Function | Wire color

1 | GND | Ground to Throttle | Pink

2 | +3V3 | +3V3 Power to Throttle | Brown

4 | THROTTLE | 0-3V3 Analog Signal from Throttle routed to AIN-1 | Yellow
