tmartin07/Vehicle-wiring-diagrams/Complete System/X-403.pdf

## M8 8-position

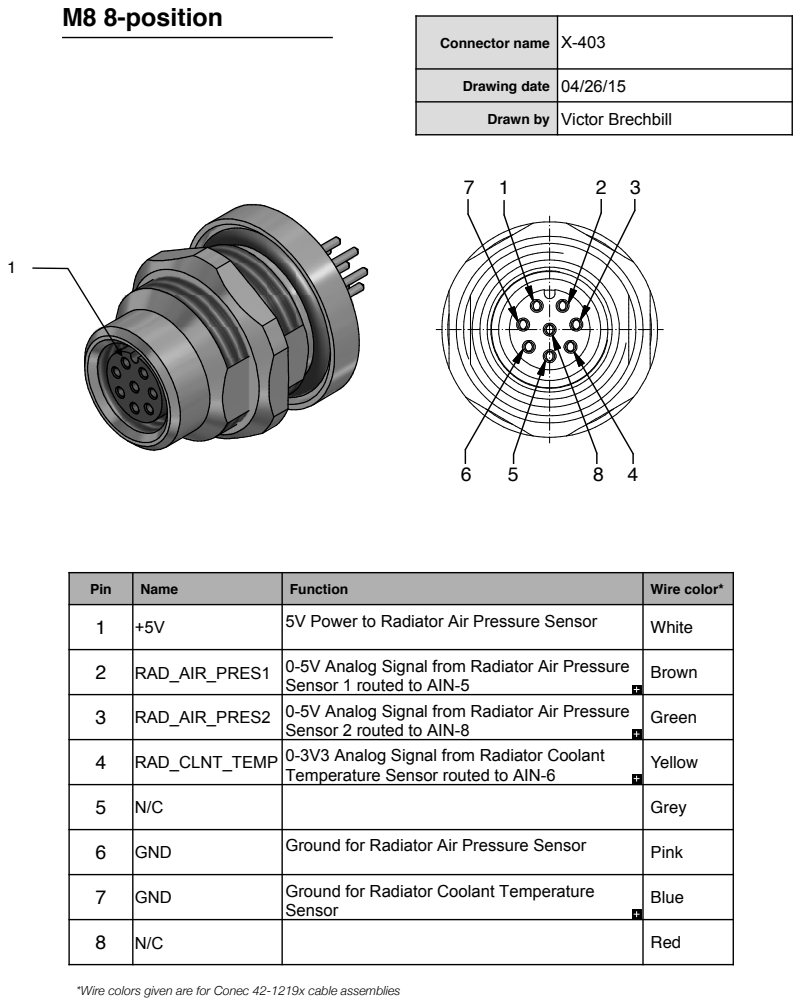
[picture p24: page 1]
Sensor

Connector name | X-403

Drawing date | 04/26/15

Drawn by | Victor Brechbill

Pin | Name | Function | Wire color*

1 White | +5V | 5V Power to Radiator Air Pressure Sensor

2 Brown | RAD_AIR_PRES1 | 0-5V Analog Signal from Radiator Air Pressure

Sensor 1 routed to AIN-5

3 Green | RAD_AIR_PRES2 | 0-5V Analog Signal from Radiator Air Pressure

Sensor 2 routed to AIN-8

4 Yellow | RAD_CLNT_TEMP | 0-3V3 Analog Signal from Radiator Coolant

Temperature Sensor routed to AIN-6

5 Grey | N/C

6 Pink | GND | Ground for Radiator Air Pressure Sensor

7 Blue | GND | Ground for Radiator Coolant Temperature

8 Red | N/C

*Wire colors given are for Conec 42-1219x cable assemblies
