tmartin07/Vehicle-wiring-diagrams/Rear Enclosure/X-340.pdf

# Micro-Fit - 2-circuit

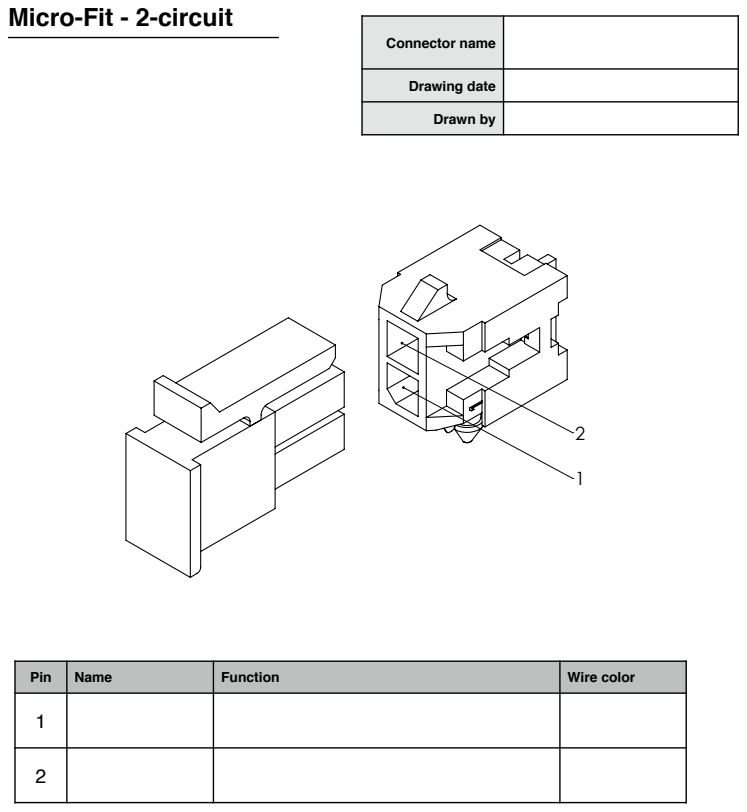
[picture p25: page 1]

Connector name X-340

Drawing date 05/08/15

Drawn by Victor Brechbill

Pin | Name | Function | Wire color

1 +12V +12V CAN Power Supply Black
