tmartin07/Vehicle-wiring-diagrams/Tank Enclosure/X-411.pdf

## M8 8-position

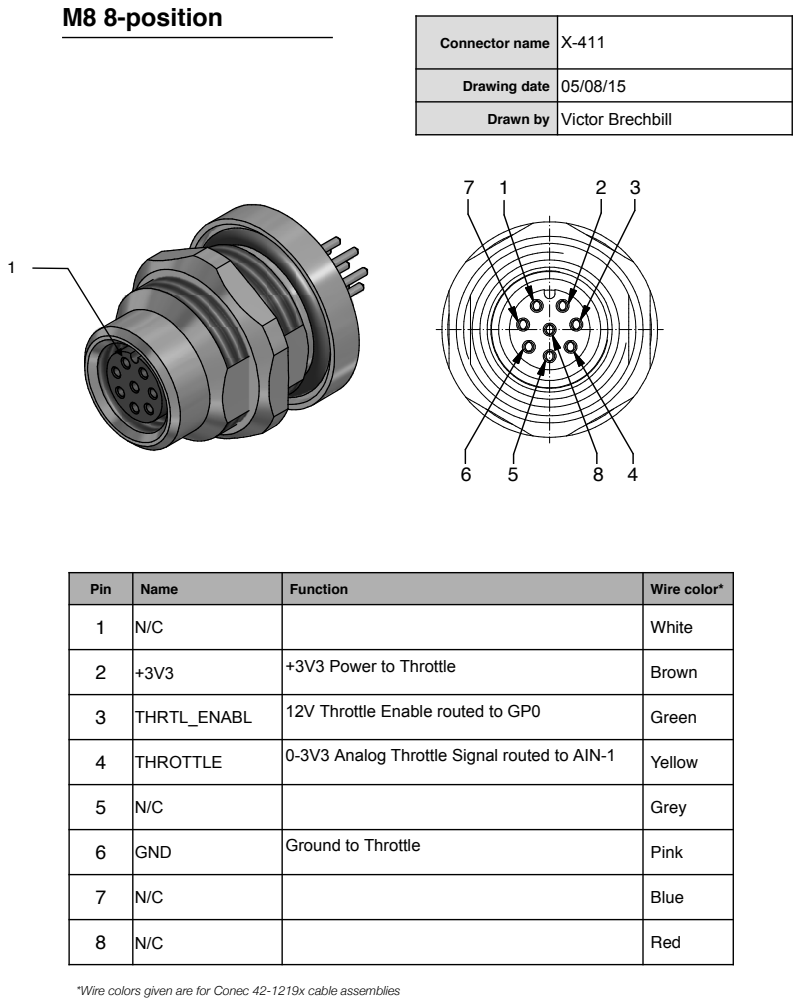
[picture p26: page 1]

Connector name | X-411

Drawing date | 05/08/15

Drawn by | Victor Brechbill

Pin | Name | Function | Wire color*

1 White | N/C

2 Brown | +3V3 | +3V3 Power to Throttle

3 Green | THRTL_ENABL | 12V Throttle Enable routed to GP0

4 Yellow | THROTTLE | 0-3V3 Analog Throttle Signal routed to AIN-1

5 Grey | N/C

6 Pink | GND | Ground to Throttle

7 Blue | N/C

8 Red | N/C

*Wire colors given are for Conec 42-1219x cable assemblies
