tmartin07/Vehicle-wiring-diagrams/Front Enclosure/Front Enclosure Drawing.pdf

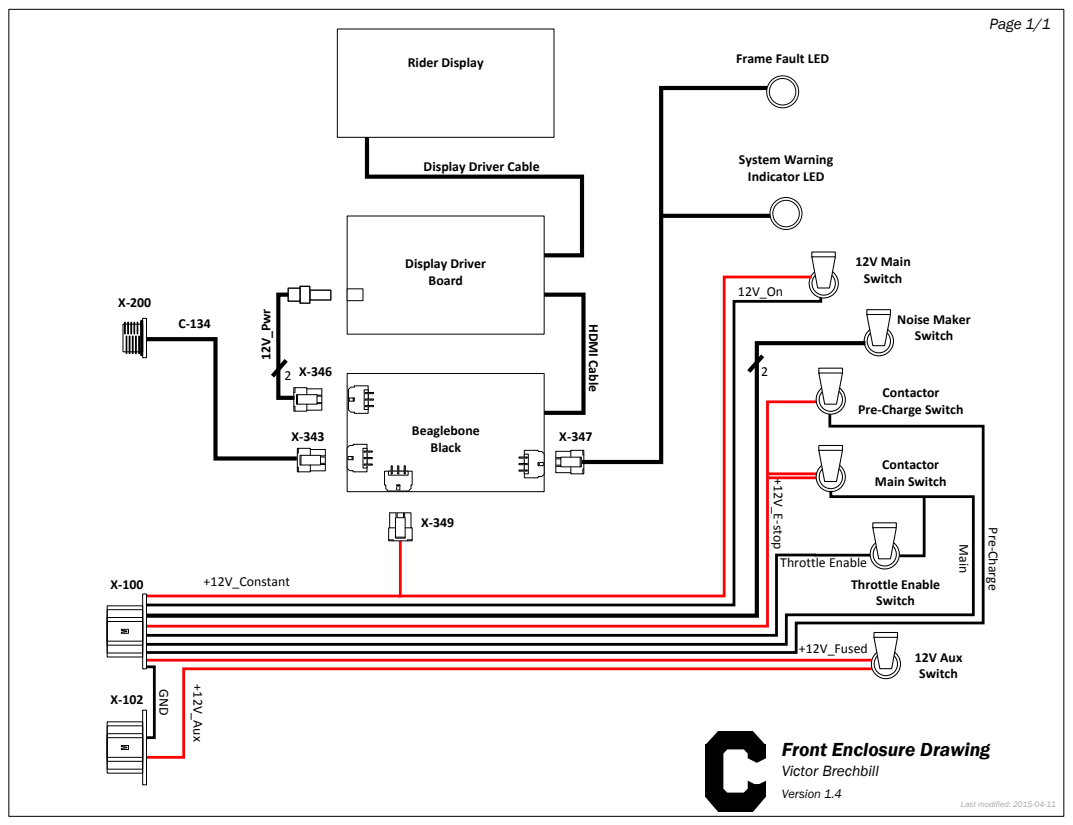
[picture p27: page 1]
Version 1.4; Last modified: 2015-04-11; Page 1/1; Beaglebone Black; Display Driver Board; Rider Display; HDMI Cable; System Warning Indicator LED; Contactor Main Switch; 12V Main Switch; 12V Aux Switch; +12V_E-stop; +12V_Fused; +12V_Aux; Main; Pre-Charge; GND; 12V_Pwr; Throttle Enable; Throttle Enable Switch; +12V_Constant; Noise Maker Switch

Frame Fault LED

Display Driver Cable

Contactor
Pre-Charge Switch

Front Enclosure Drawing
Victor Brechbill
