tmartin07/Vehicle-wiring-diagrams/Rear Enclosure/Rear Enclosure Diagram.pdf

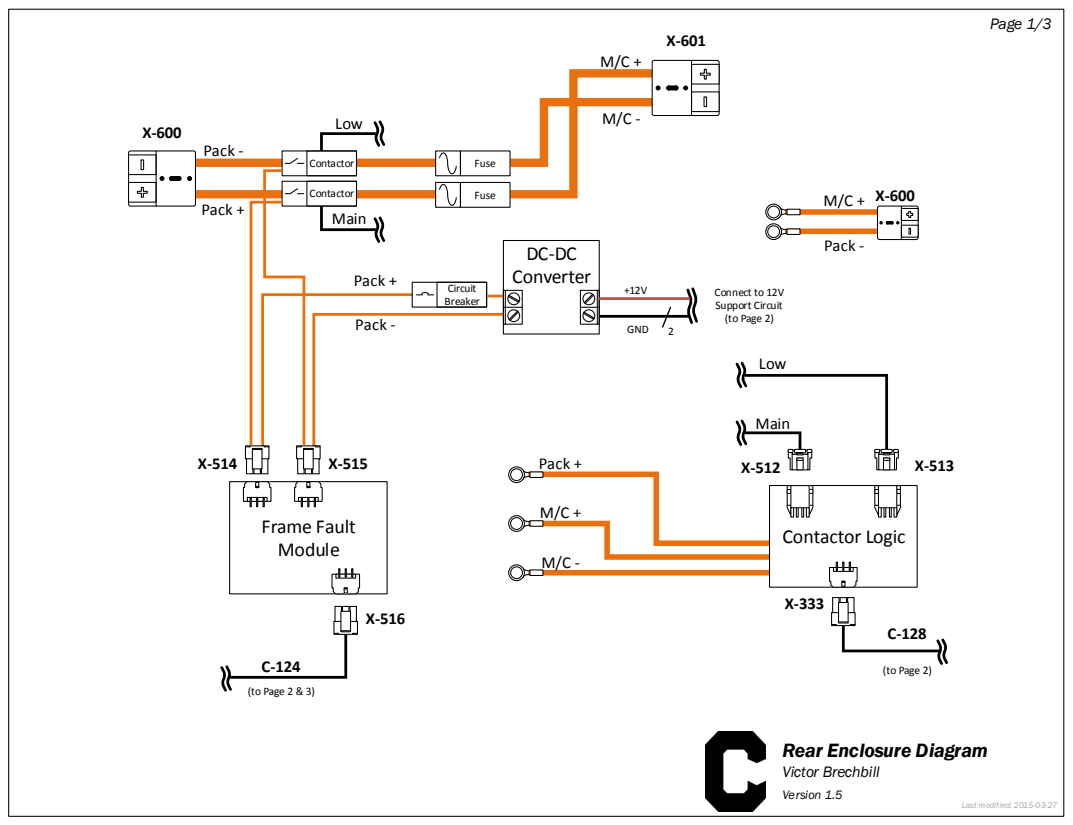
[picture p28: page 1]
Version 1.5; Last modified: 2015-03-27; Frame Fault Module; Contactor; Fuse; Contactor Logic; Pack -; Pack +; Low; Main; (to Page 2); (to Page 2 & 3); Circuit Breaker; DC-DC Converter; Connect to 12V Support Circuit (to Page 2); GND

Rear Enclosure Diagram
Victor Brechbill

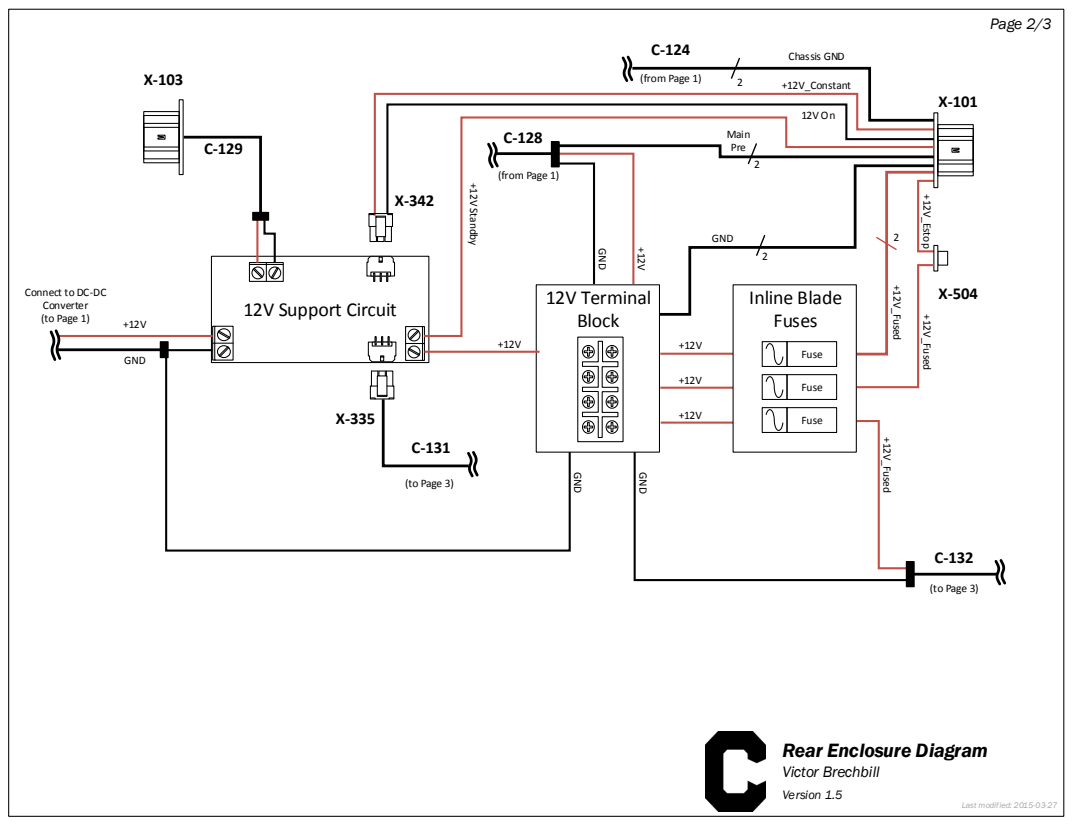
[picture p29: page 2]
12V Support Circuit; 12V Terminal; Block; Main Pre; +12V_Estop; (from Page 1); (to Page 3); +12V_Fused; GND; Inline Blade Fuses; Fuse; +12V_Constant; Chassis GND; +12V Standby

Connect to DC-DC
Converter
(to Page 1)

Rear Enclosure Diagram

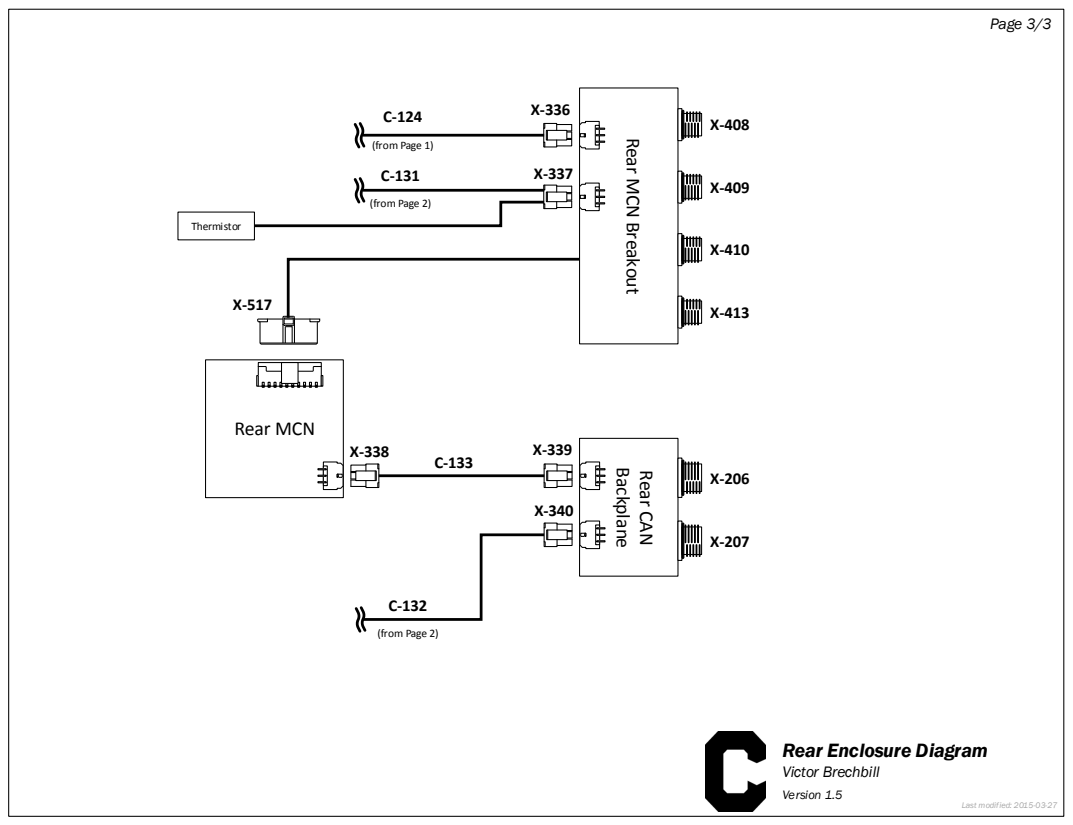
[picture p30: page 3]
Rear MCN; (from Page 1); (from Page 2); Thermistor

Rear MCN Breakout Backplane Rear CAN

Rear Enclosure Diagram
