tmartin07/Vehicle-wiring-diagrams/Tank Enclosure/Tank Enclosure Diagram.pdf

## Page 1/2

## Kvaser

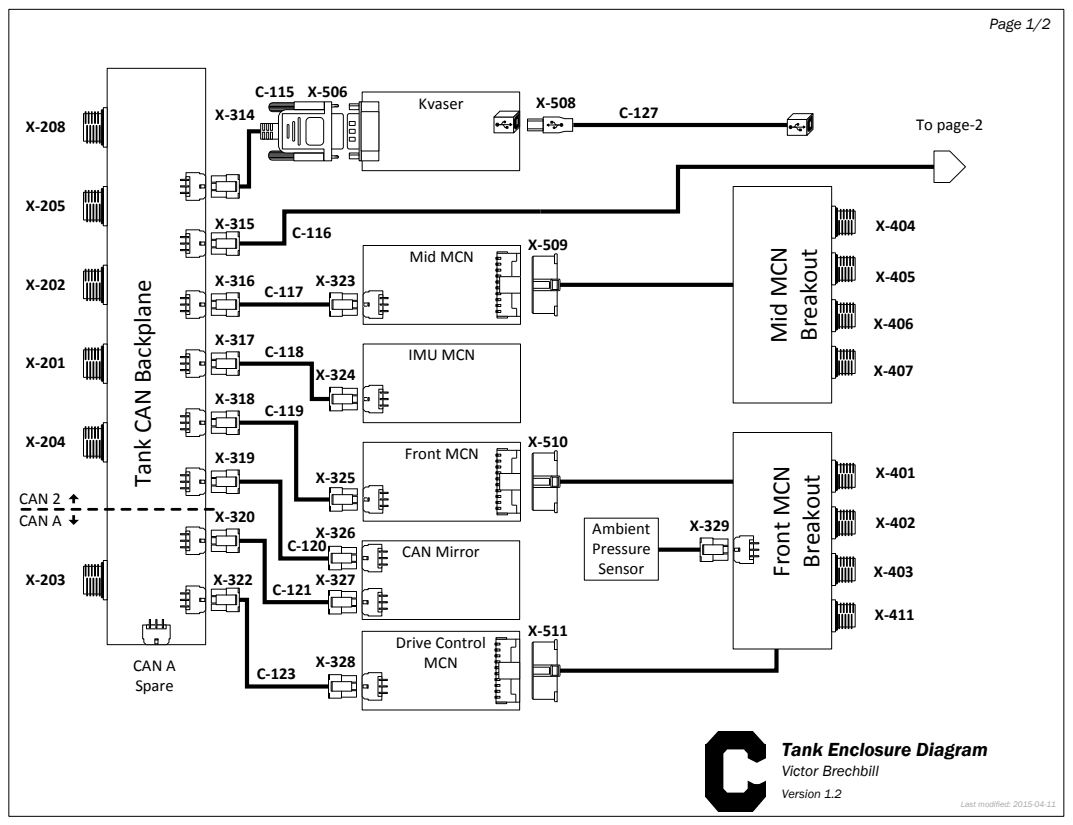
[picture p31: page 1]
Version 1.2; Last modified: 2015-04-11; CAN Mirror; Front MCN; IMU MCN; Mid MCN; Drive Control MCN; Ambient Pressure Sensor; Breakout; CAN A Spare; To page-2

Tank CAN Backplane

Breakout CAN A CAN 2 X-401 X-402

Tank Enclosure Diagram
Victor Brechbill

## Page 2/2

## NoiseMaker MCN

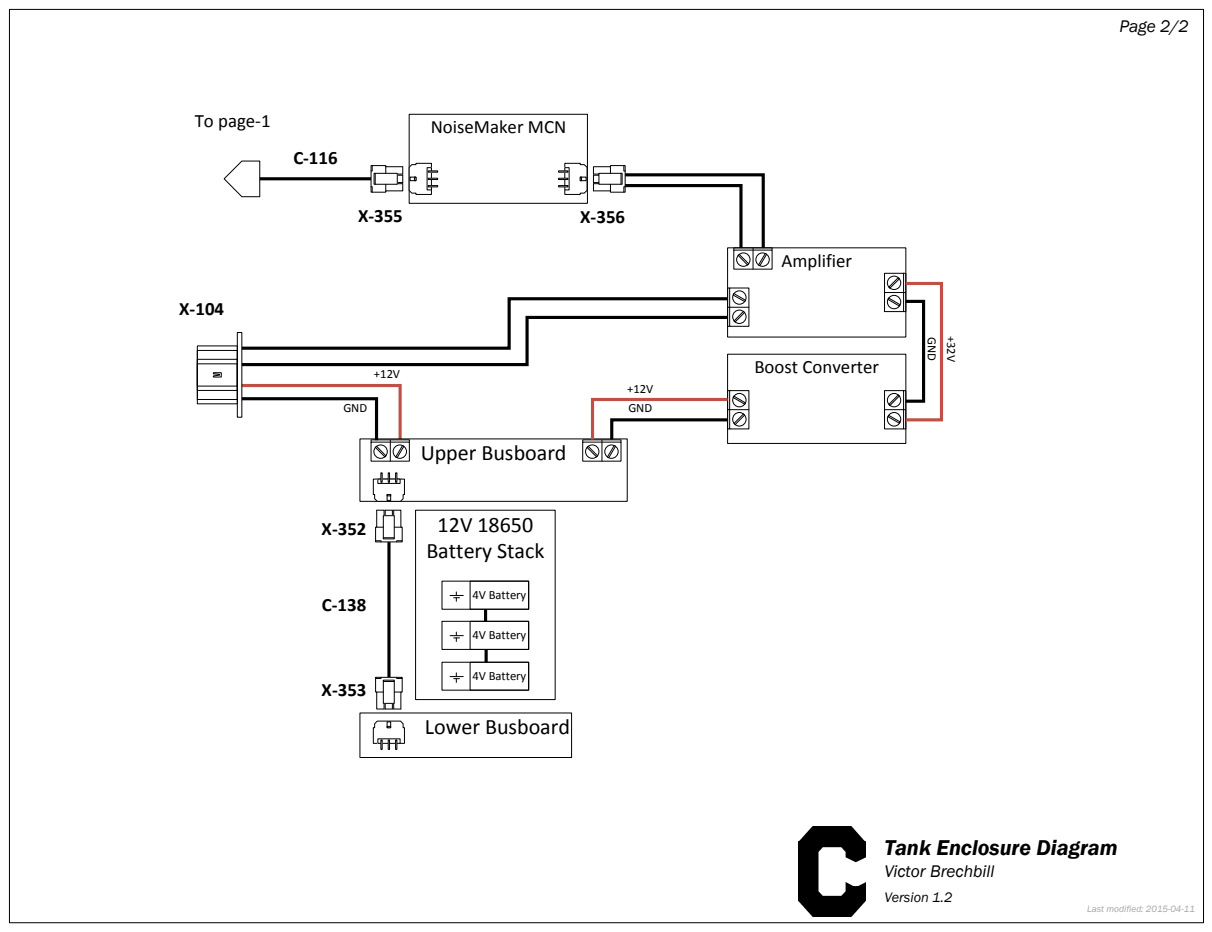
[picture p32: page 2]
Version 1.2; Last modified: 2015-04-11; Boost Converter; Amplifier; 12V 18650 Battery Stack; 4V Battery; Upper Busboard; Lower Busboard; GND; To page-1

Tank Enclosure Diagram
Victor Brechbill
