tmartin07/Vehicle-wiring-diagrams/Dyno Stand/Dyno Electrical System Diagram.pdf

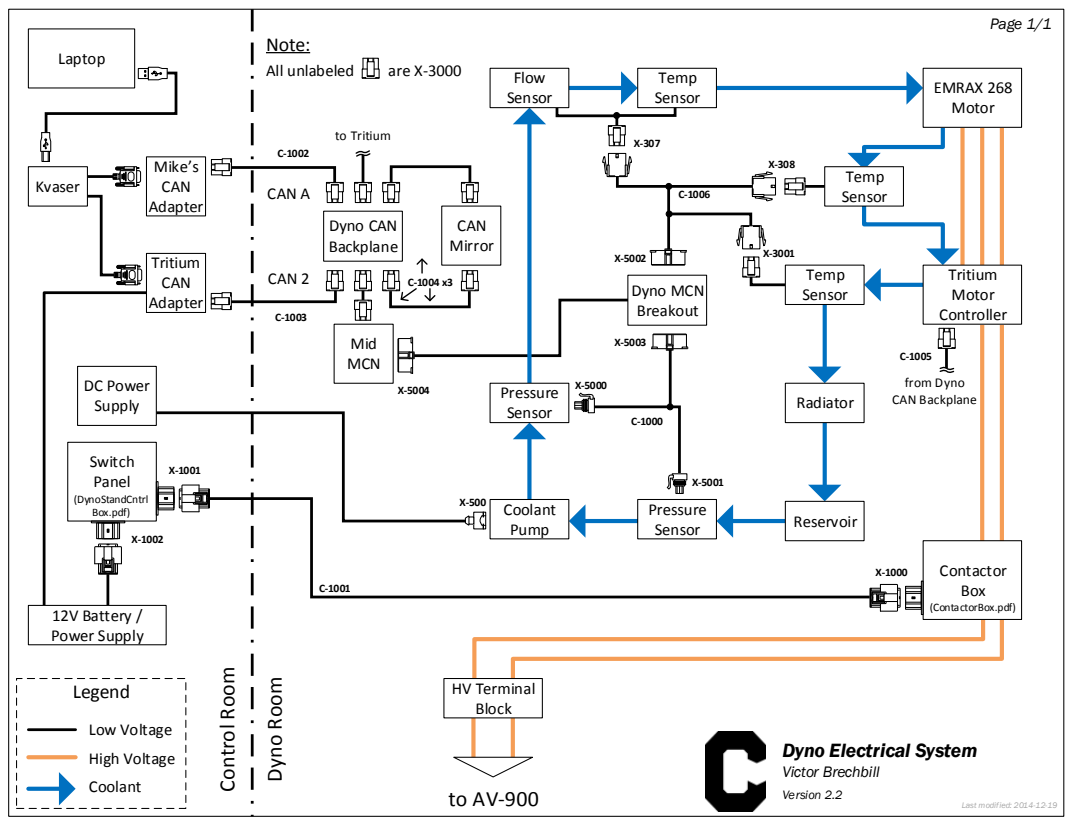
[picture p33: page 1]
Version 2.2; Last modified: 2014-12-19; Laptop; Kvaser; Mike’s CAN Adapter; Mid MCN; Tritium Motor Controller; EMRAX 268 Motor; Temp Sensor; Radiator; Reservoir; Pressure Sensor; Coolant Pump; Flow Sensor; Dyno MCN Breakout; DC Power Supply; 12V Battery / Power Supply; Switch Panel; Contactor Box; HV Terminal Block; Dyno Room; Control Room; Tritium CAN Adapter; CAN 2; CAN A; (DynoStandCntrl Box.pdf); (ContactorBox.pdf); Legend; Low Voltage; High Voltage; Coolant; Dyno CAN Backplane; Note: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

Dyno Electrical System
Victor Brechbill
