tmartin07/Vehicle-wiring-diagrams/Dyno Stand/DynoStandCntrlBox.pdf

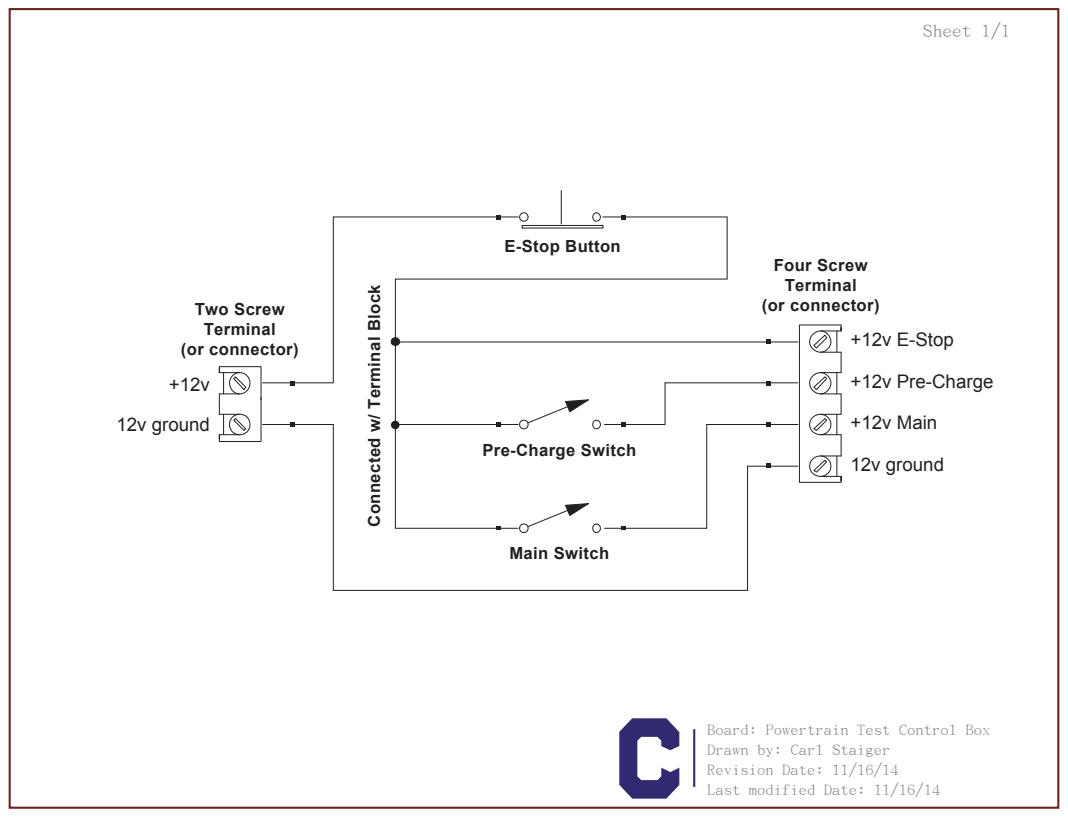
[picture p34: page 1]
Sheet 1/1; Main Switch; E-Stop Button; +12v E-Stop; +12v Pre-Charge; +12v Main; 12v ground; Four Screw Terminal (or connector); Two Screw Terminal (or connector)

Connected w/ Terminal Block

Pre-Charge Switch

Board: Powertrain Test Control Box
Drawn by: Carl Staiger
Revision Date: 11/16/14
Last modified Date: 11/16/14
