tmartin07/Vehicle-wiring-diagrams/Rear Enclosure/X-333.pdf

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

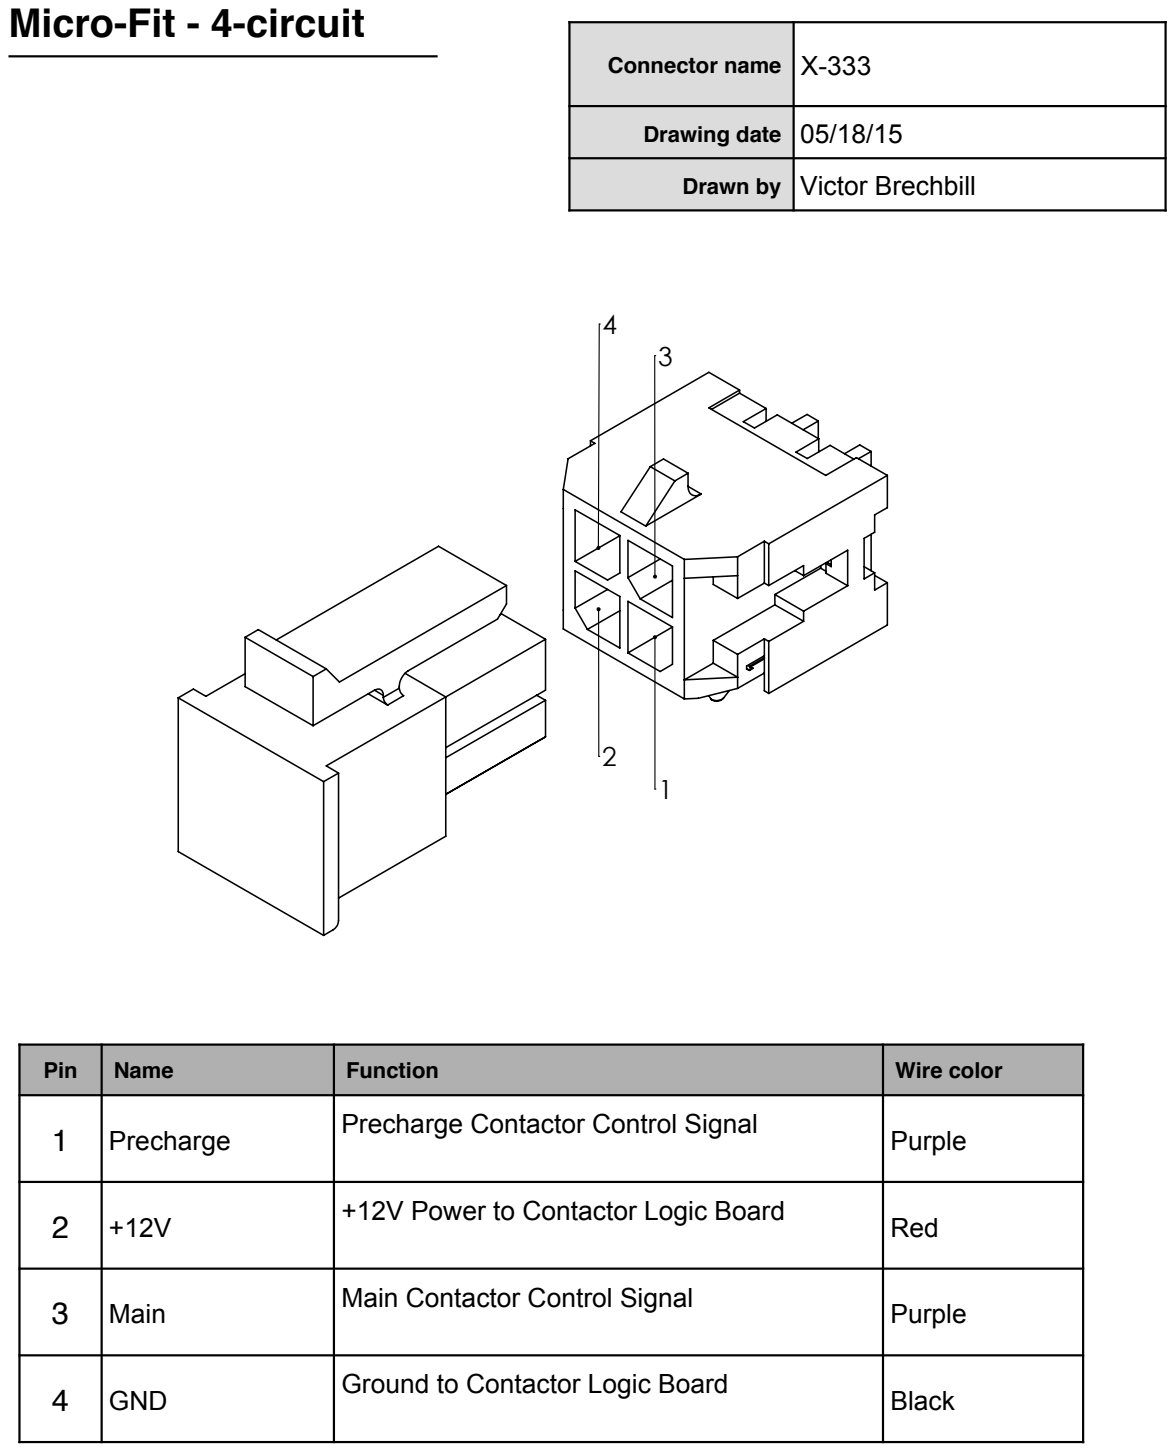
[picture p36: page 1]
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
