tmartin07/Vehicle-wiring-diagrams/Complete System/X-306.pdf

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

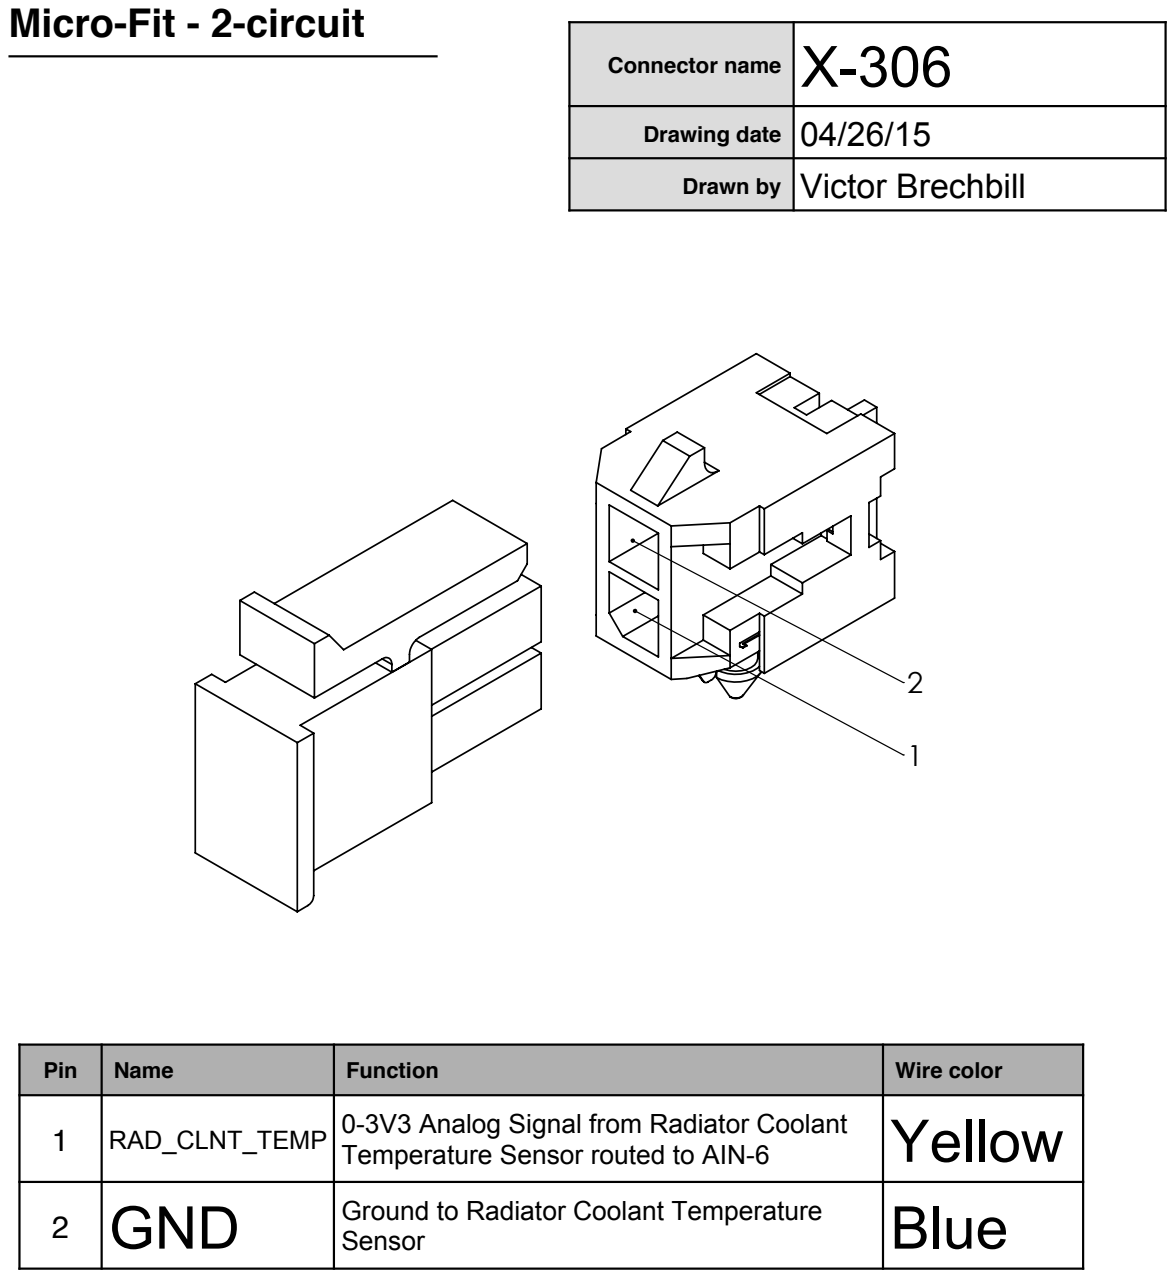
[picture p41: page 1]
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
