tmartin07/Vehicle-wiring-diagrams/Complete System/X-409.pdf

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

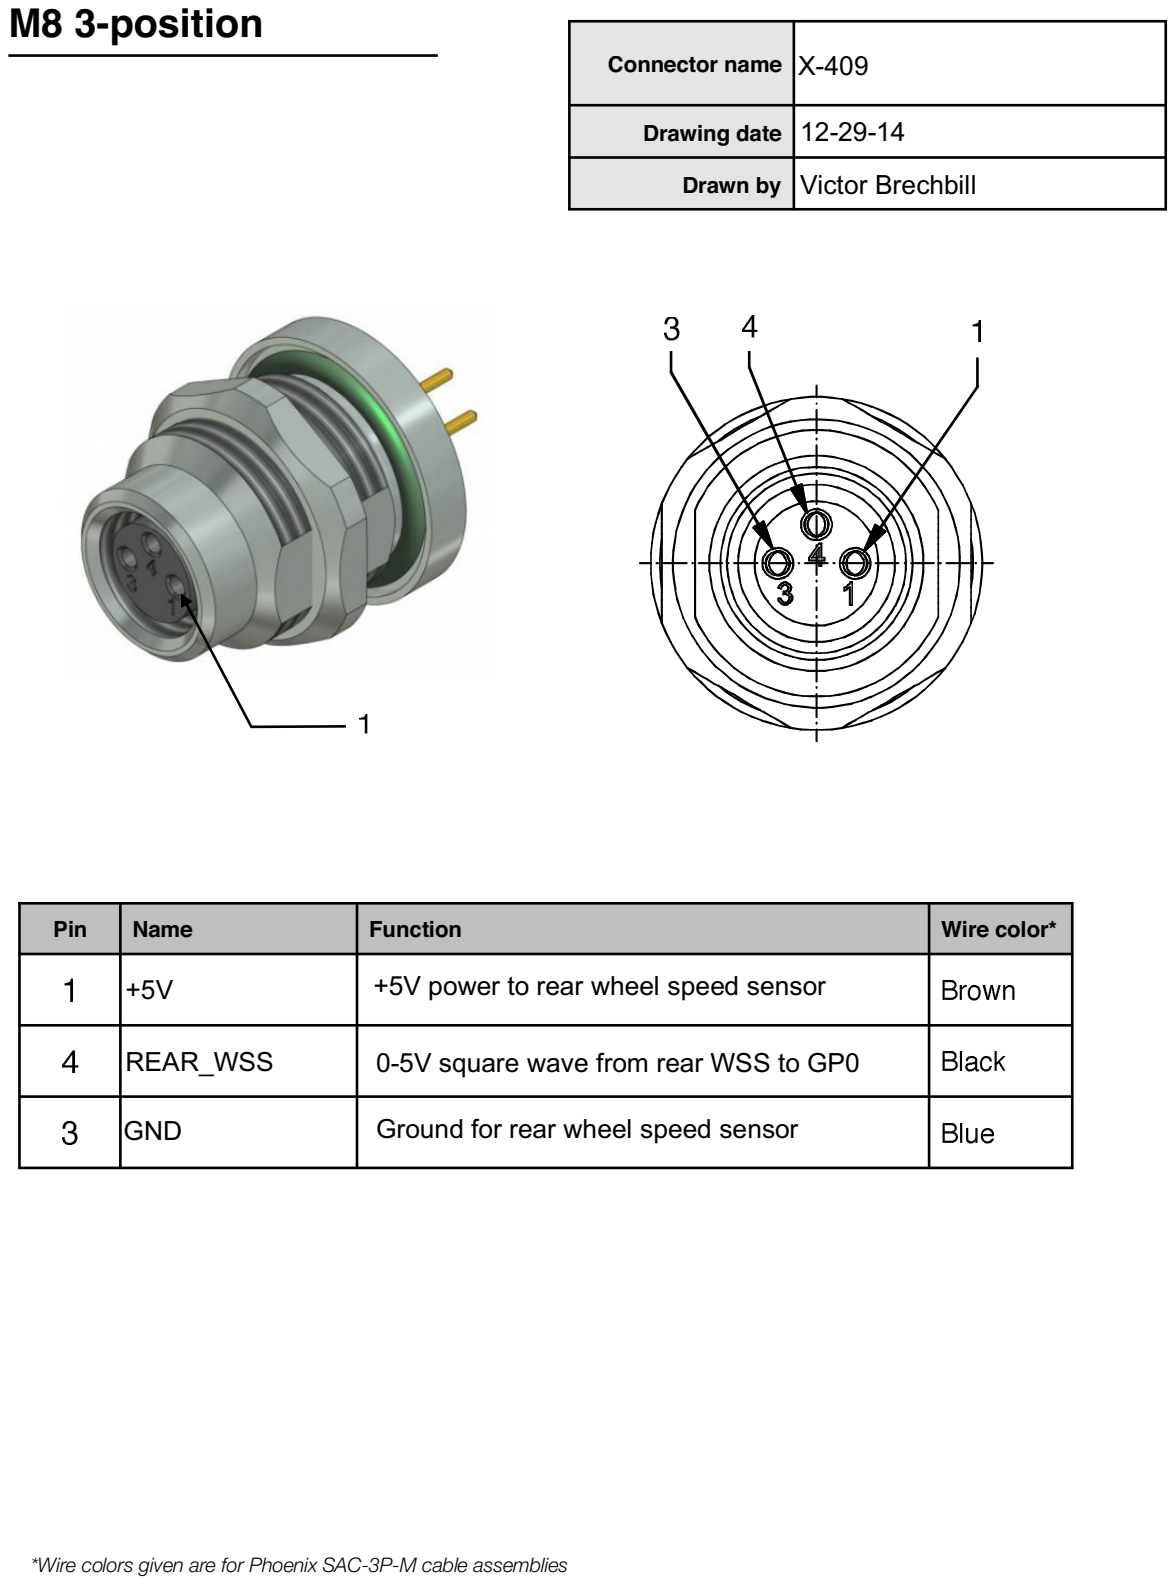
[picture p50: page 1]
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
