tmartin07/Vehicle-wiring-diagrams/Dyno Stand/X-5003_wrong.pdf

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

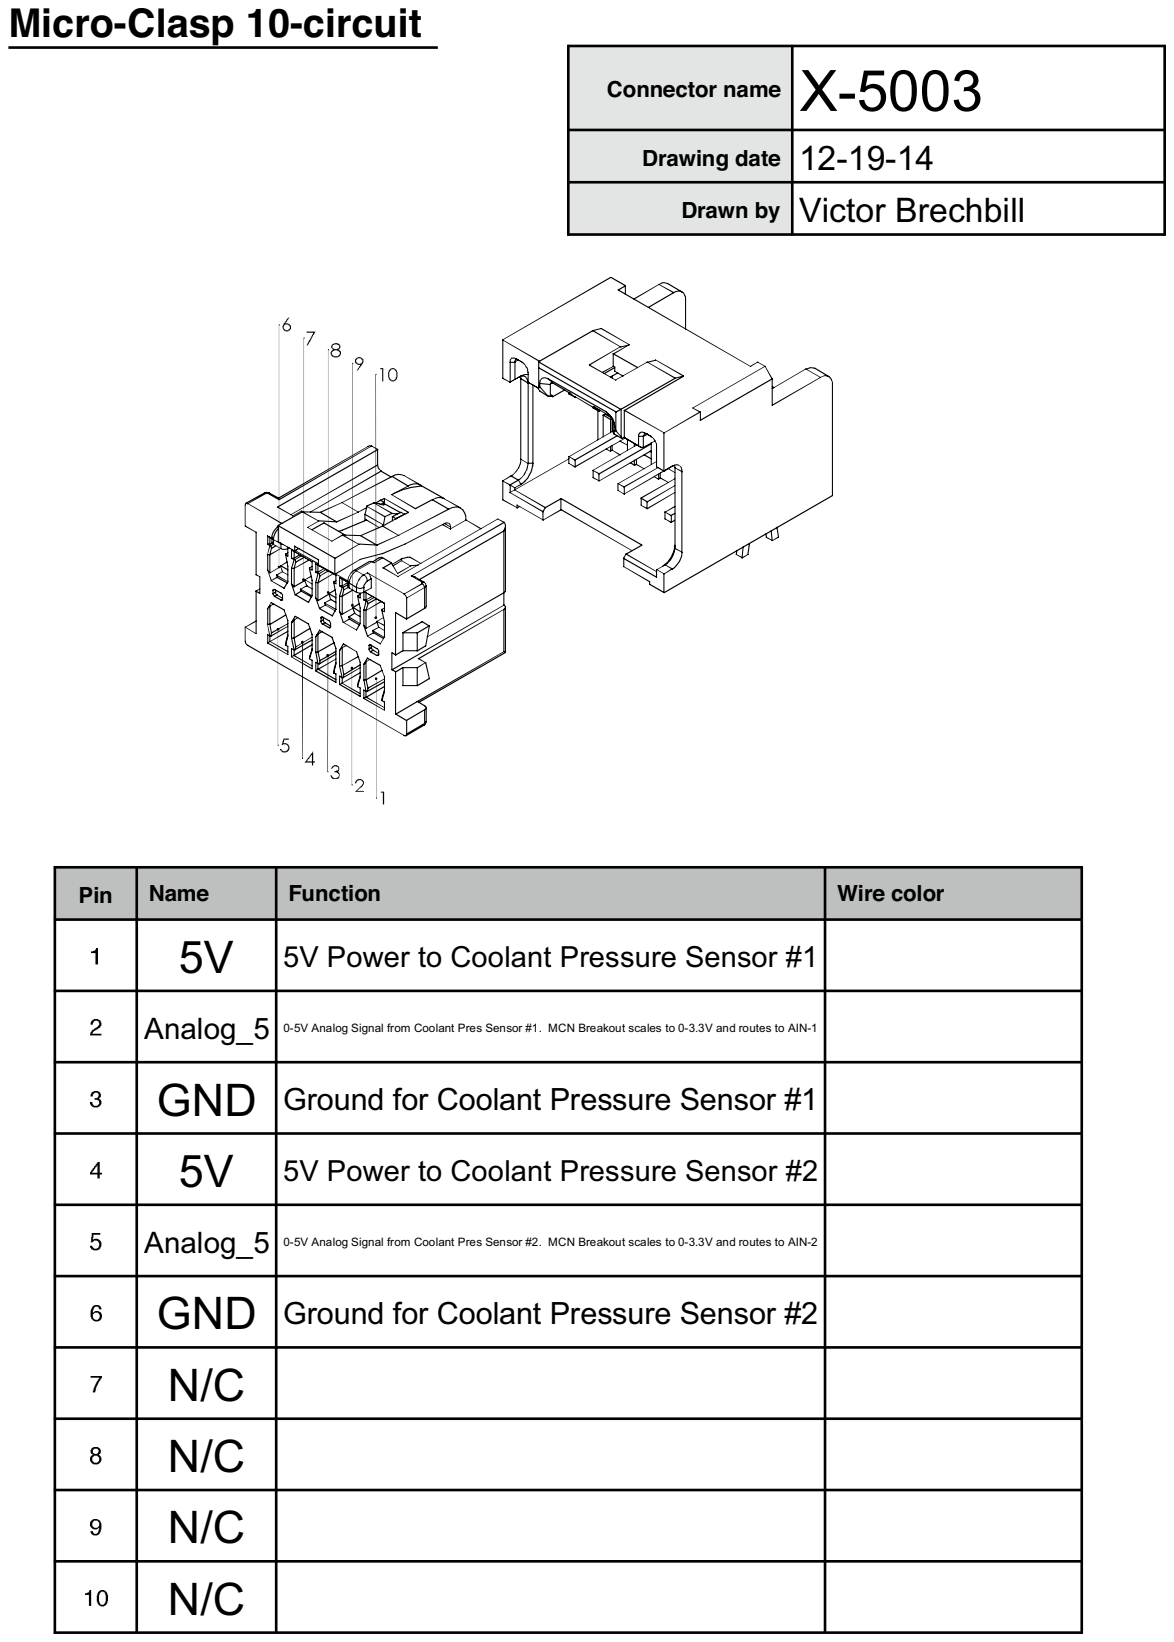
[picture p61: page 1]
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
