tmartin07/Vehicle-wiring-diagrams/Rear Enclosure/X-103.pdf

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
