tmartin07/Vehicle-wiring-diagrams/Dyno Stand/ContactorBox.pdf

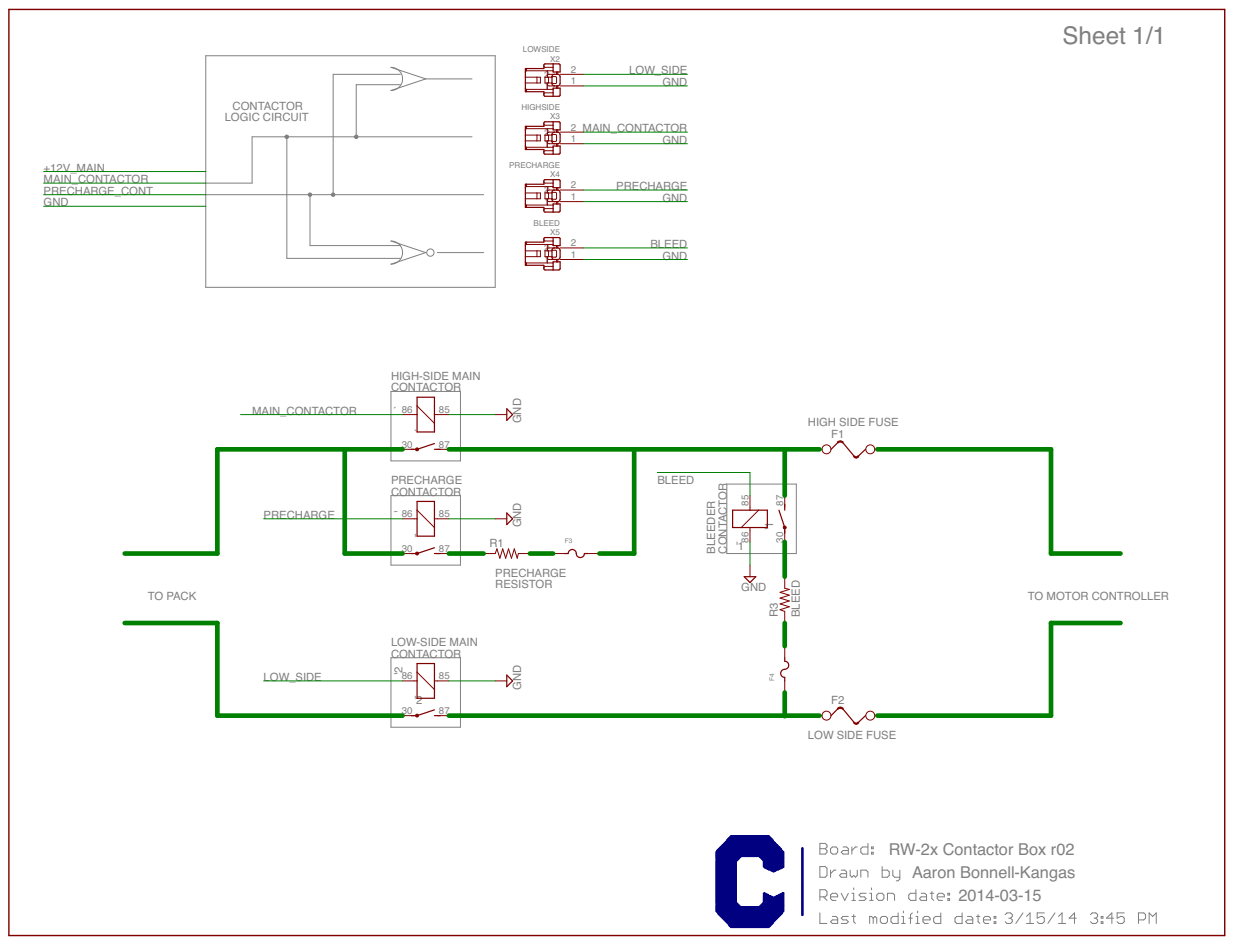
[picture p63: page 1]
