tmartin07/Vehicle-wiring-diagrams/(commit log)

2014-10-29 Add contactor box diagram from RW-2x
    [Contactor box.sch]
2014-11-19 start drawing tail enclosure schematic
2014-11-23 Added throttle, Starlane display, and resolver to System Diagram
2014-11-28 Created file for Tank Enclosure Diagram
2014-11-30 Add pinout template for M8-8 sensor connector
2014-11-30 Updated RW-3 Electrical System Diagram to V1.1 Updated Dyno Electrical System Diagram to V1.1 Created Tank Enclosure Diagram V1.0 Created RW-3 Connector Master List
    [RW-3 Connector Master List.xlsx]
2014-12-03 Updated Dyno Electrical System Diagram to V1.2
    Created Dyno Electrical System Diagram V2.0
    ***Important Note: This does not obsolete V1.2, both will be used in separate test conditions. V2.0 adds CAN Mirror into Dyno configuration.
    [RW-3 Connector Master List.xlsx]
2014-12-03 Updates on Rear Enclosure Diagram
2014-12-05 Made progress on Rear Enclosure Diagram
    [RW-3 Connector Master List.xlsx]
2014-12-06 Updated Dyno System Diagram to Version 2.1 to replace Mid MCN breakout with Dyno MCN breakout Updated Connector Master List to match these changes to Dyno System Diagram Updated all drawings with "MC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
    [RW-3 Connector Master List.xlsx]
2014-12-13 Fixed pinouts for M12s to match the wiki
    [MCN Breakout Pinouts.xlsx, RW-3 Connector Master List.xlsx]
2014-12-19 Created Rear Enclosure Diagram Version 1.0 Updated RW-3 Electrical System Diagram to Version 1.2 Updated RW-3 Connector Master List for Rear Enclosure connectors
    [RW-3 Connector Master List.xlsx]
2014-12-19 Added connector pinout drawings for Dyno Stand Update Dyno Electrical System Diagram to Version 2.2 (created new connector numbers) Updated RW-3 Connector Master List Updated MCN Breakout Pinouts
    [MCN Breakout Pinouts.xlsx, RW-3 Connector Master List.xlsx]
2014-12-30 Added pinout drawings for Dyno Stand
    [MCN Breakout Pinouts.xlsx]
2014-12-30 Created pinout drawings for front, mid, and rear MCN breakout boards
2014-12-31 Uploaded resolver board datasheet
2015-01-06 Updated pinouts after decision was made to use only 8-pos M8s instead of 3, 5, and 8-pos. Last version is no longer compatible.
    [MCN Breakout Pinouts.xlsx]
2015-01-11 Discovered mistake in 10-pos Microclasp pinout diagram
    [MCN Breakout Pinouts.xlsx]
2015-02-15 Added X-341 for Strain Gauge to Connector Master List
    [RW-3 Connector Master List.xls, RW-3 Connector Master List.xlsx]
2015-02-17 Created Rear Enclosure Diagram V1.1 to reflect new 12V support circuit & 12V battery. Updated RW-3 Connector Master List
    [RW-3 Connector Master List.xls]
2015-03-02 Removed taillight and horn from Complete System Diagram. Added Front Enclosure Diagram (Carl) Updated Rear Enclosure Diagram to reflect 18650 12V support circuit
    [RW-3 Connector Master List.xls]
2015-03-02 Forgot 12V grounds in X-101 in previous commit. Corrected here
2015-03-02 Fix typo in Front Enclosure drawings
2015-03-05 Updated Front Enclosure Diagram, RW-3 Electrical System Diagram, and Connector Master List to reflect changes discussed in 03-04-15 meeting with ABK and Carl about the Indicator lights and Throttle D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
    [MCN Breakout Pinouts.xls, MCN Breakout Pinouts.xlsx, RW-3 Connector Master List.xls]
2015-03-07 Changed Rear Enclosure Diagram, Tank Enclosure Diagram, Front Enclosure Diagram, RW-3 Electrical System Diagram, and RW-3 Connector Master List to reflect the following changes:
    Added +12V Constant from 12V support (rear) to BeagleBone (front).
    Moved Throttle to Front MCN Breakout.
    Removed Starlane from Tank
    Moved Throttle Enable to X-100
    [BOM.ods, RW-3 Connector Master List.xls]
2015-03-16 Changed Front and Rear Enclosure Diagrams to reflect change involved in removing X-350. 12V const is now run to both the Beaglebone and the 12V On switch via the same wire. Also removed the 18650 12V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
    [MCN Breakout Pinouts.xls, RW-3 Connector Master List.xls]
2015-03-22 Updated with changes from sensors review meeting 03-22-15
    [MCN Breakout Pinouts.xls]
2015-03-27 Updated Rear Enclosure dwg to add thermistor, chassis GND, and 12V standby signal
    [BOM.ods, RW-3 Connector Master List.xls]
2015-03-28 Updated MCN pinout to add 12V STANDBY
    [BOM.ods, MCN Breakout Pinouts.xls]
2015-03-29 Updated with Motor Air Pressure 2 and Radiator Air Pressure 2
    [MCN Breakout Pinouts.xls]
2015-04-09 Updated Connectors for Upper and Lower Busboards
    [RW-3 Connector Master List.xls]
2015-04-10 Added connectors for strain gauge
    [RW-3 Connector Master List.xls]
2015-04-12 Updated Tank Enclosure drawings to include Noise Maker electronics. Updated Front Enclosure drawing to include Noise Maker switch. Updated RW-3 Electrical System Diagram and RW-3 Connector Master Lis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
    [RW-3 Connector Master List.xls]
2015-05-13 Added connector pinouts corresponding to harness parts made on 05/08/15
    [RW-3 Connector Master List.xls, X-100.xlsx, X-101.xlsx, X-502.xlsx]
2015-05-20 Added Pinouts for Connectors used in Rear Enclosure, for Rear Sensors, for CAN Connectors, and for PL-8 Balance Harness
    [CAN MicroFit.xlsx, X-503.ods]
2015-05-20 Connector Pinouts updated with Wiring Harness Progress made on 5/19/15
    [RW-3 Connector Master List.xls, X-307.xlsx]
2015-05-20 Fixed issue with mislabeled pin on PL8 (33->15)
2015-05-27 Add documentation for motor interface.
    [RW-3 motor interface.sch]
2017-03-12 Create Battery Pack
2017-10-01 UPDATED
    Making Wire diagrams to be moved to box instead
